ThyFriendlyFox/agentcast-prototype/agent-kit/STATUS.md

# STATUS.md — where the project actually stands

The single source of truth for project state. Claims require evidence: a
passing gate, a linked run, a tag. Updated in the same commit as the
behavior change. The weekly cycle (WEEKLY.md step 5) refreshes it.

| Area | State | Evidence |
|---|---|---|
| v0.5 stick with ESP32-P4, 80 x 30 mm, 8 layers | 🚧 | gates GREEN (ERC, DRC, SIM, EXPORT; `make verify`); not ordered: crystal value, DSI skew open (`hardware/v0.5/README.md`) |
| v0.5 fab files | ✅ | `hardware/v0.5/dongle/fab/` from `make fab` |
| v0.5 firmware | ❌ | not started |
| v0.4 CM5 stick with male plug | 🧊 | archived at `223e73b` |
| v0.3 stick design | 🧊 | archived at `f83c855`; superseded by v0.4 |
| v0.3 CM5 position | ✅ | matches Raspberry Pi's CM5 3D model (RP-007222-DD-2) |
| v0.3 fab files | ✅ | `hardware/v0.3/dongle/fab/` from `make fab` |
| v0.2 one-board dongle | 🧊 | archived at `6d5fa2a`; superseded by v0.3 |
| v0.1 main board and mic bar | 🧊 | archived at `2c0782a`; superseded by v0.2 |
| Firmware / OS image | ❌ | not started |

States: ✅ done (gated) · 🚧 in progress · ❌ not started · 🧊 frozen/won't do.

## Current week

- **Shipping:** between cycles
- **Last release:** none
- **Known red:** none.
