ThyFriendlyFox/agentcast-prototype/hardware/v0.5/dongle/docs/board-3d-top.png

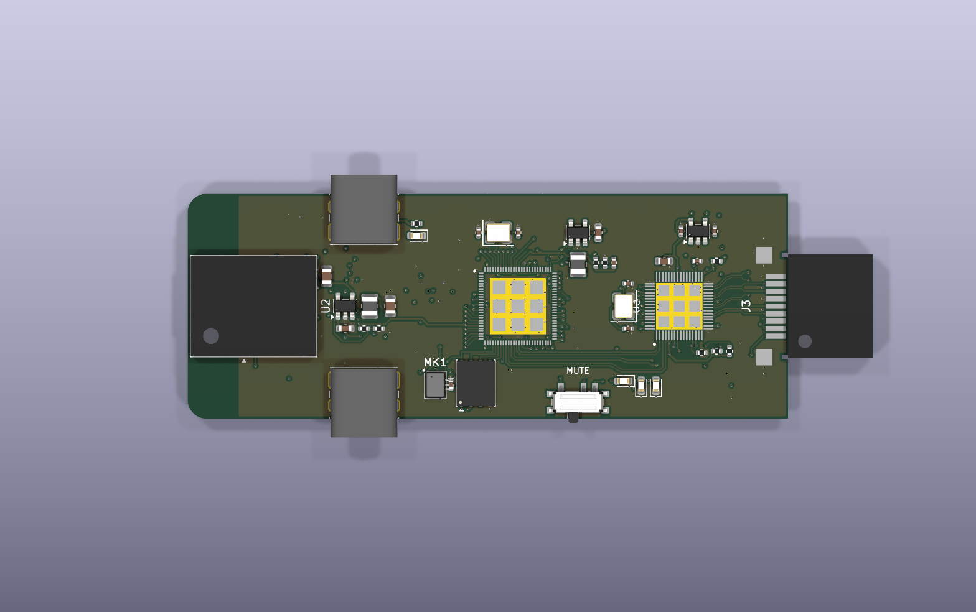
hardware/v0.5/dongle/docs/board-3d-top.png
