ThyFriendlyFox/agentcast-prototype/hardware/v0.5/dongle/docs/board-bottom.png

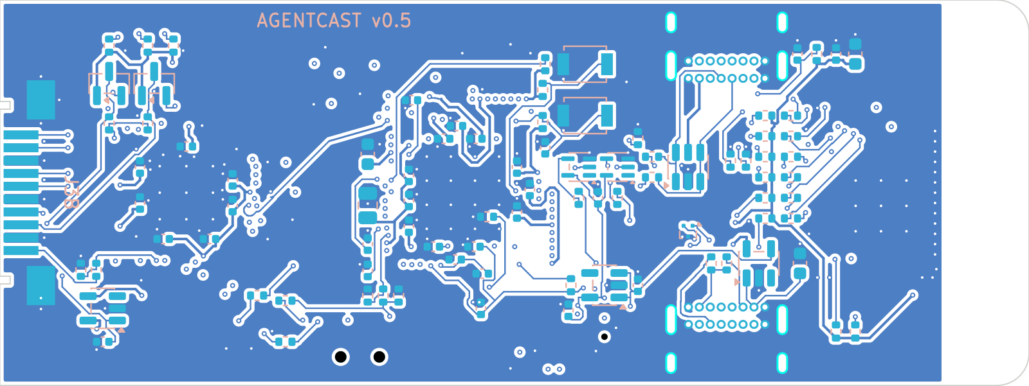
hardware/v0.5/dongle/docs/board-bottom.png
