ThyFriendlyFox/agentcast-prototype/hardware/v0.5/dongle/docs/board-top.png

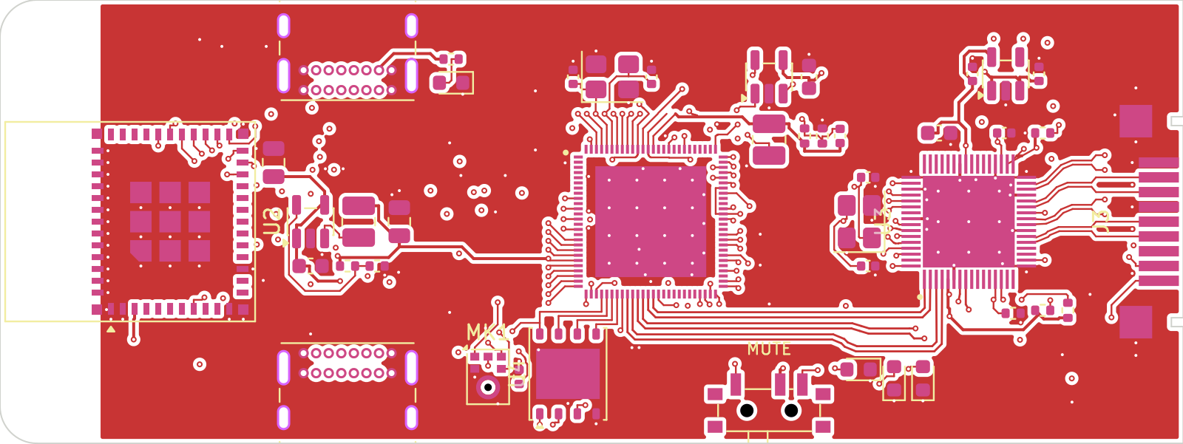
hardware/v0.5/dongle/docs/board-top.png
