ThyFriendlyFox/agentcast-prototype/hardware/v0.5/dongle/docs/layers/B-Courtyard.png

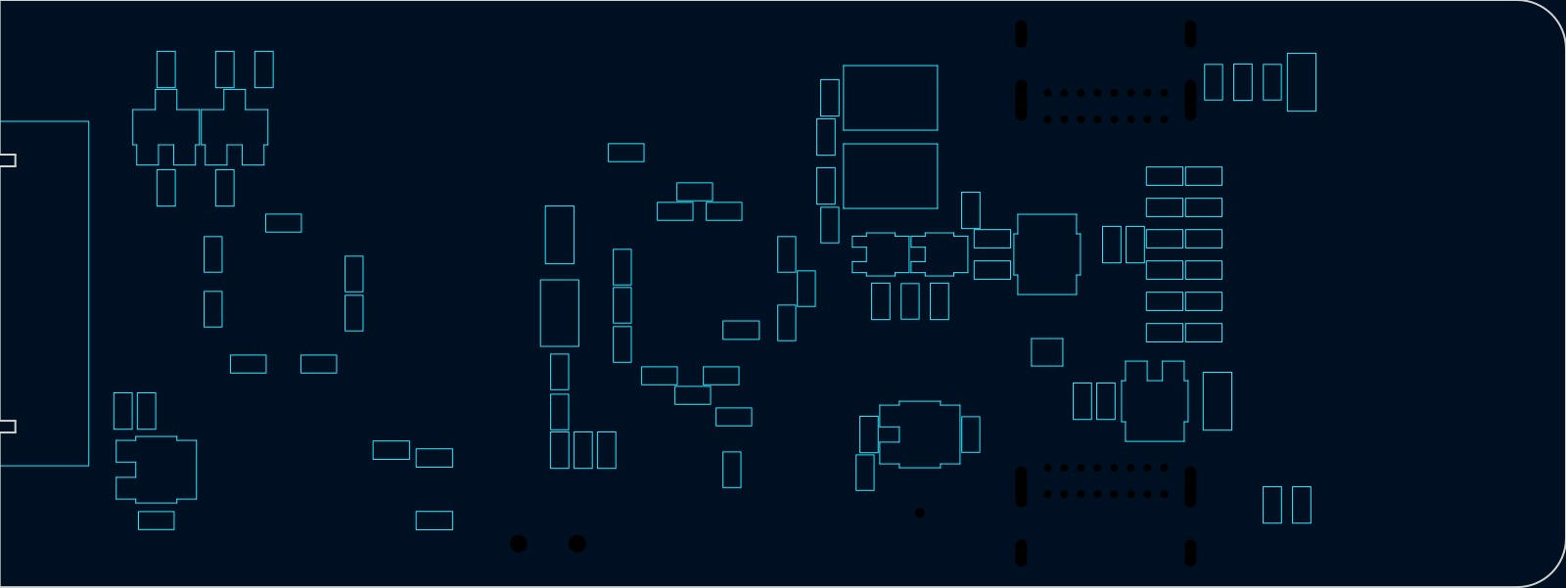
hardware/v0.5/dongle/docs/layers/B-Courtyard.png
