ThyFriendlyFox/agentcast-prototype/hardware/v0.5/dongle/docs/layers/B-Cu.png

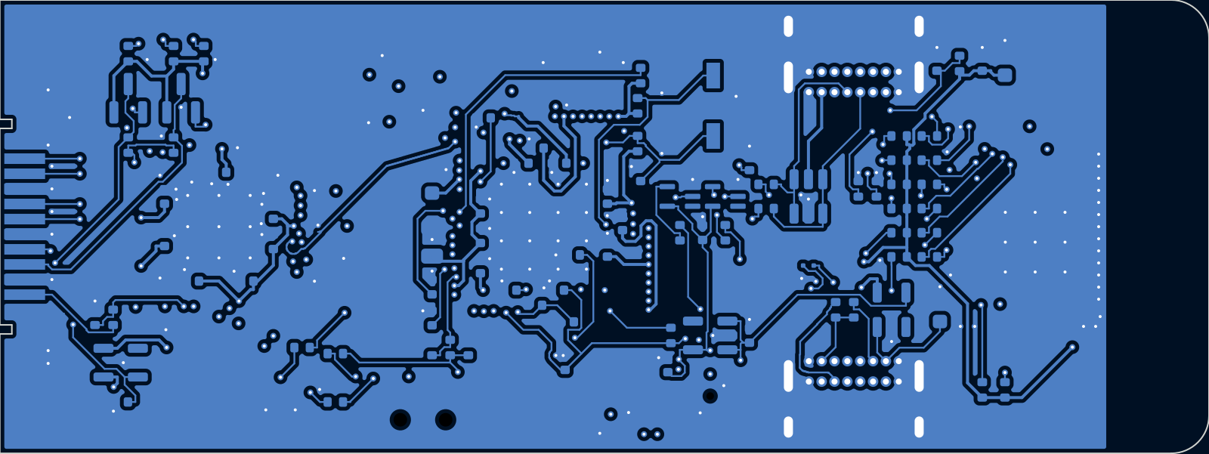
hardware/v0.5/dongle/docs/layers/B-Cu.png
