ThyFriendlyFox/agentcast-prototype/hardware/v0.5/dongle/docs/layers/B-Fab.png

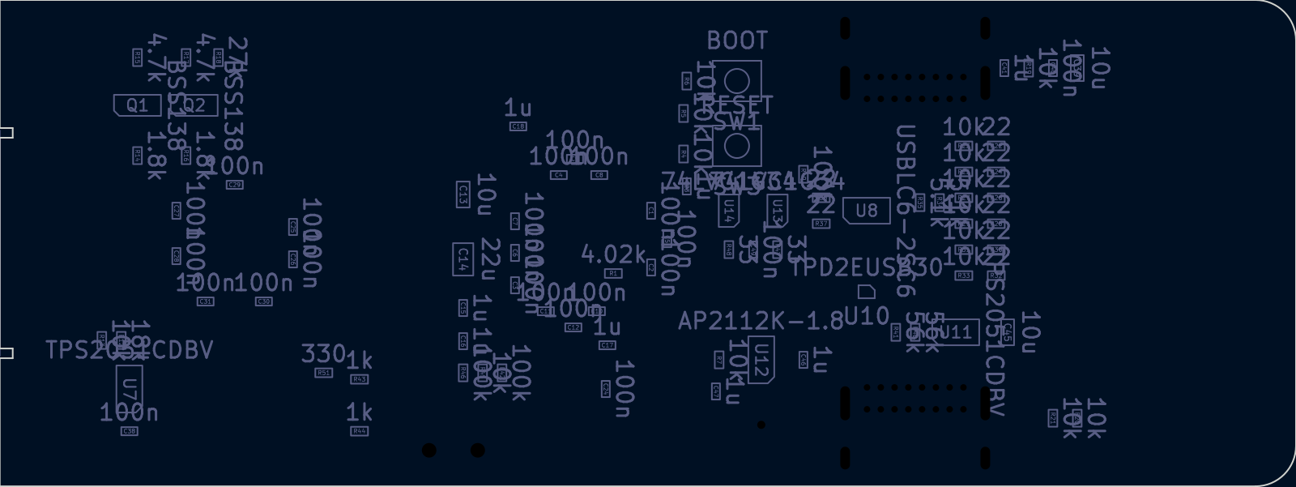
hardware/v0.5/dongle/docs/layers/B-Fab.png
