ThyFriendlyFox/agentcast-prototype/hardware/v0.5/dongle/docs/layers/B-Mask.png

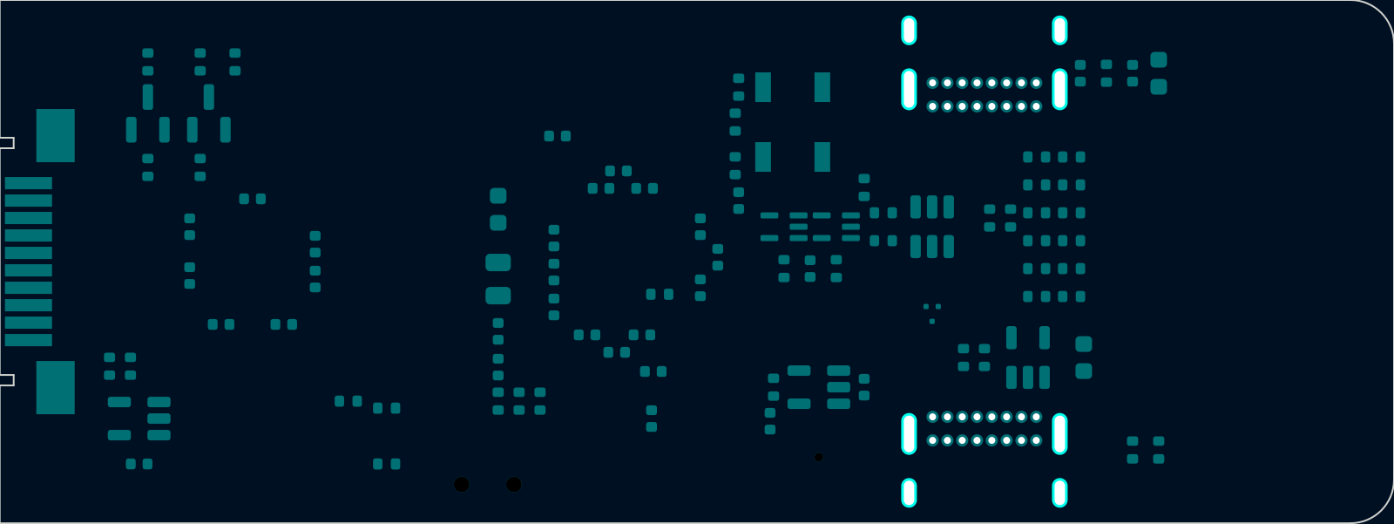
hardware/v0.5/dongle/docs/layers/B-Mask.png
