ThyFriendlyFox/agentcast-prototype/hardware/v0.5/dongle/docs/layers/B-Paste.png

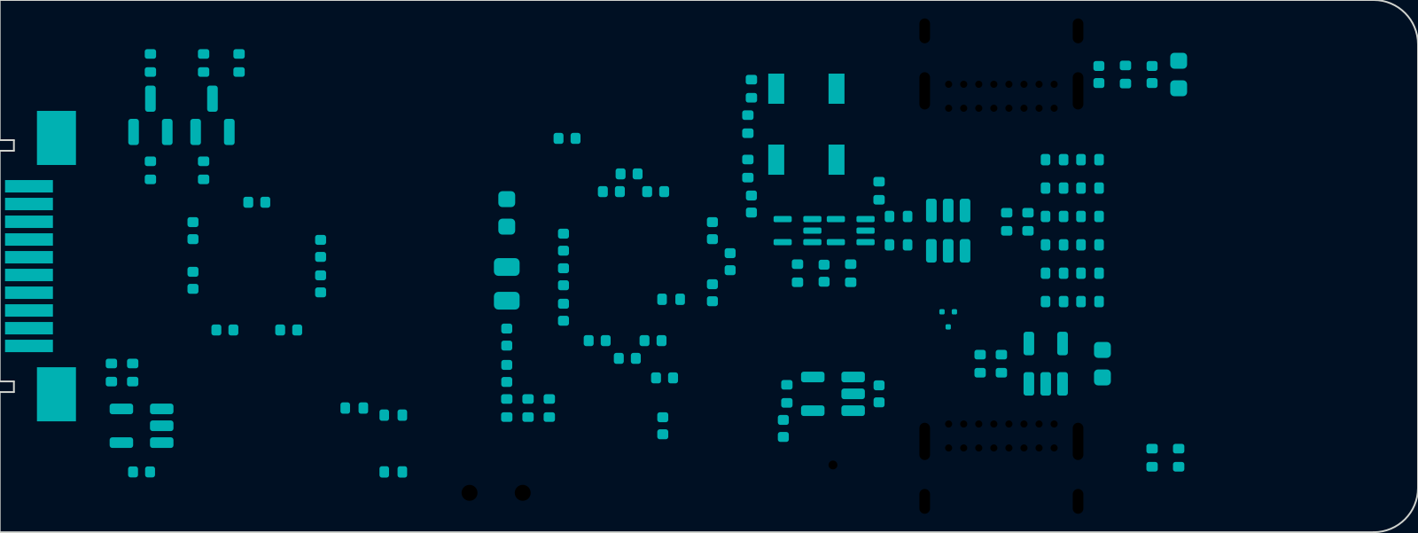
hardware/v0.5/dongle/docs/layers/B-Paste.png
