ThyFriendlyFox/agentcast-prototype/hardware/v0.5/dongle/docs/layers/B-Silkscreen.png

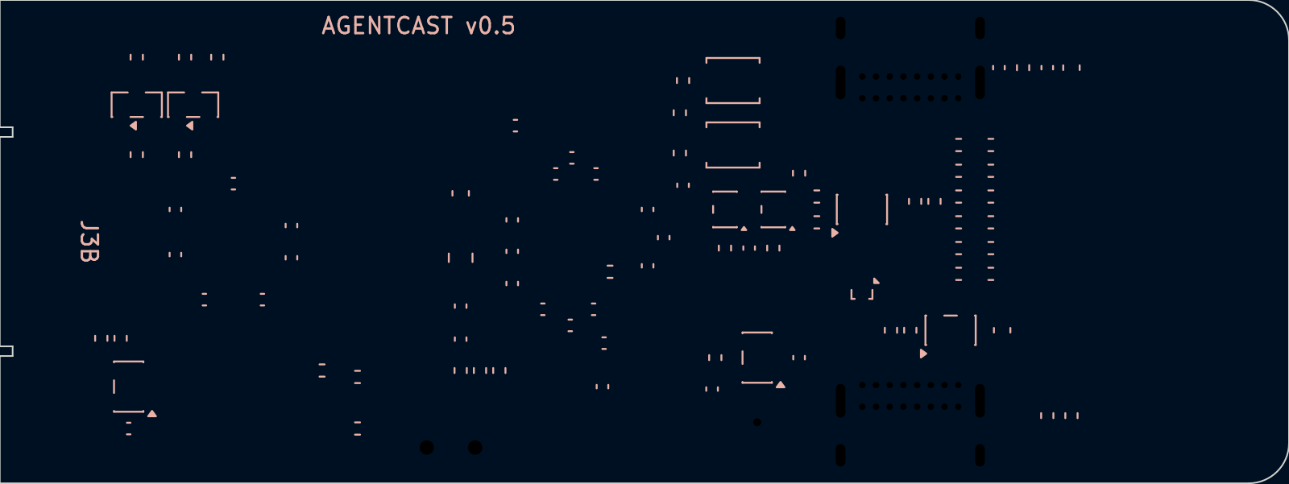
hardware/v0.5/dongle/docs/layers/B-Silkscreen.png
