ThyFriendlyFox/agentcast-prototype/hardware/v0.5/dongle/docs/layers/Edge-Cuts.png

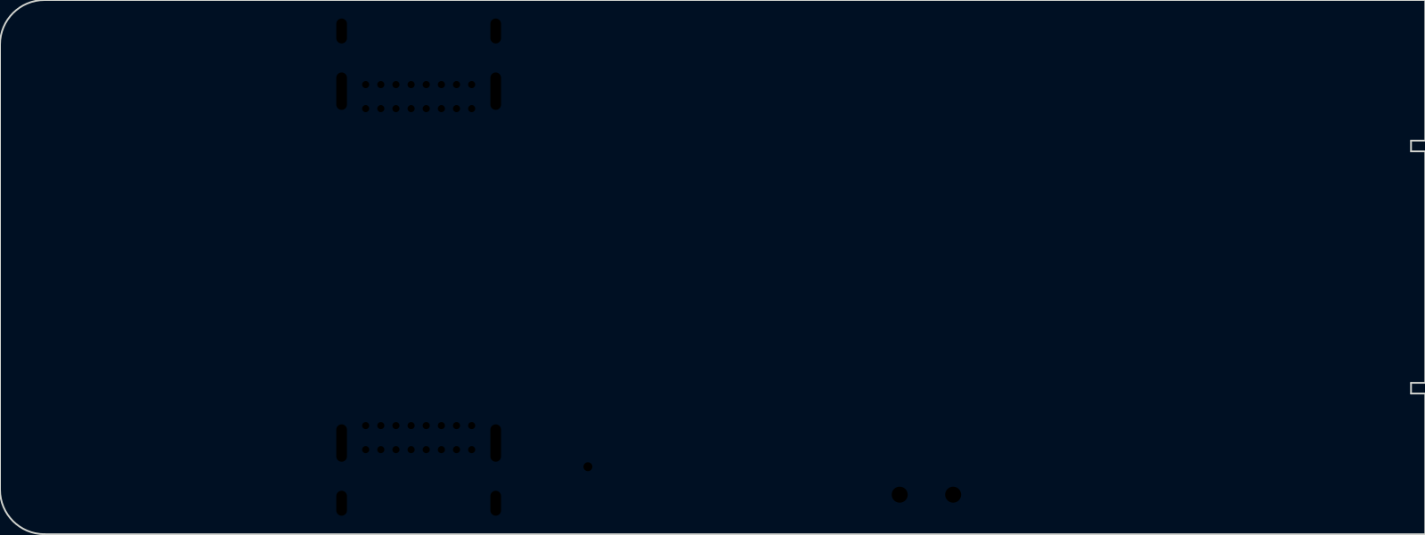
hardware/v0.5/dongle/docs/layers/Edge-Cuts.png
