ThyFriendlyFox/agentcast-prototype/hardware/v0.5/dongle/docs/layers/F-Courtyard.png

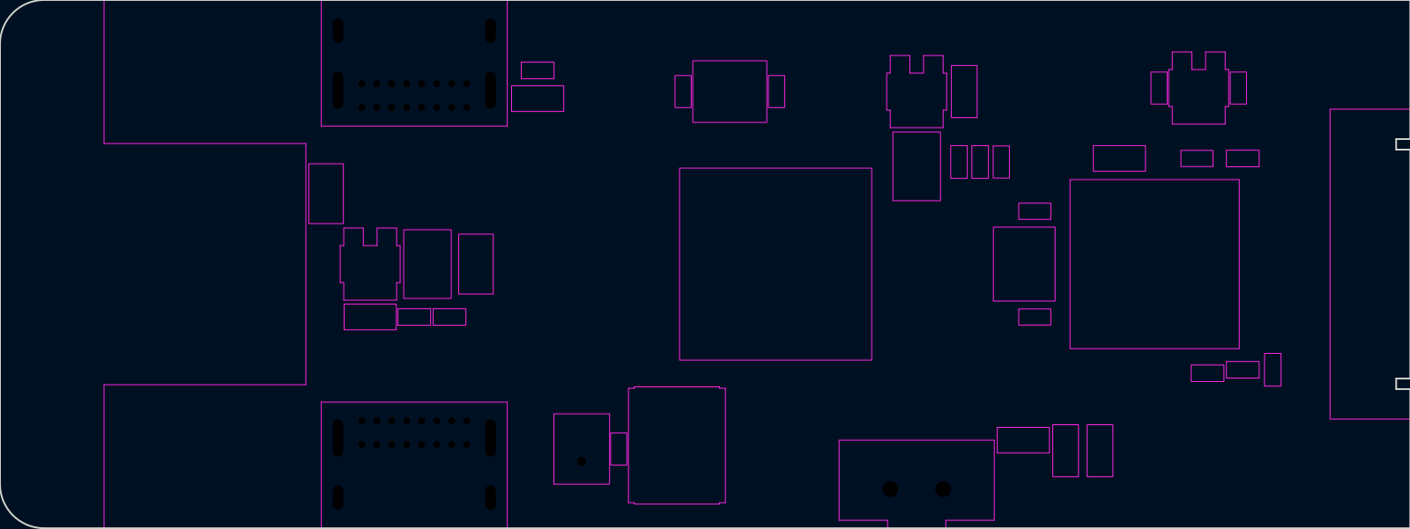
hardware/v0.5/dongle/docs/layers/F-Courtyard.png
