ThyFriendlyFox/agentcast-prototype/hardware/v0.5/dongle/docs/layers/F-Cu.png

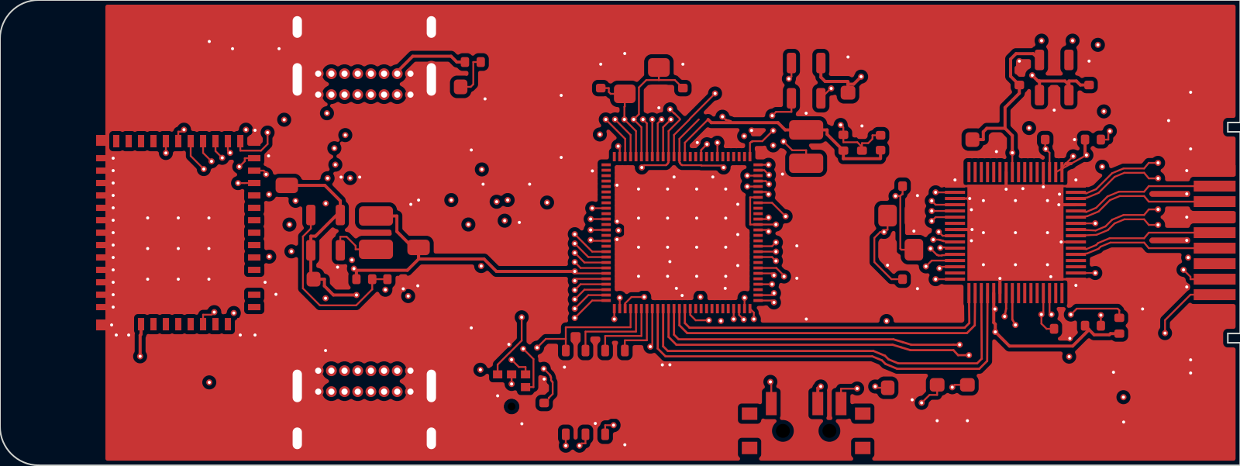
hardware/v0.5/dongle/docs/layers/F-Cu.png
