ThyFriendlyFox/agentcast-prototype/hardware/v0.5/dongle/docs/layers/F-Fab.png

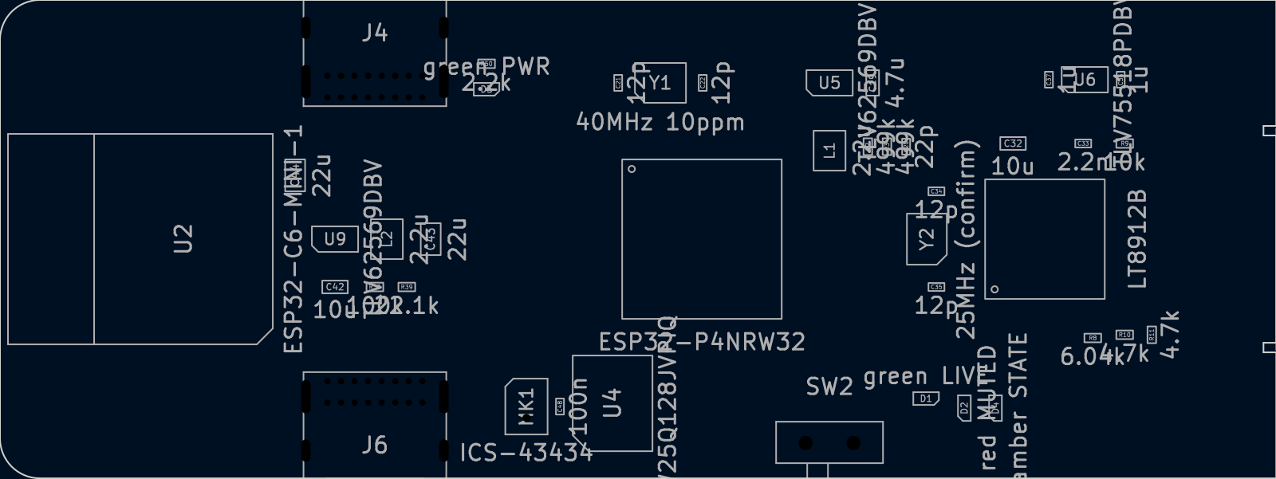
hardware/v0.5/dongle/docs/layers/F-Fab.png
