ThyFriendlyFox/agentcast-prototype/hardware/v0.5/dongle/docs/layers/F-Mask.png

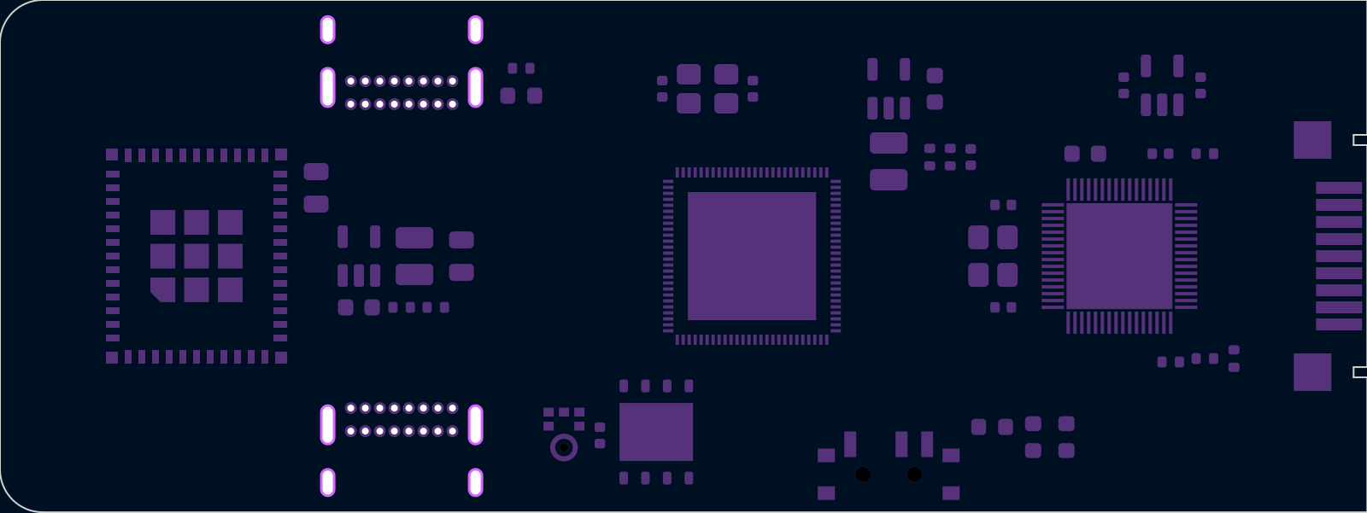
hardware/v0.5/dongle/docs/layers/F-Mask.png
