ThyFriendlyFox/agentcast-prototype/hardware/v0.5/dongle/docs/layers/F-Paste.png

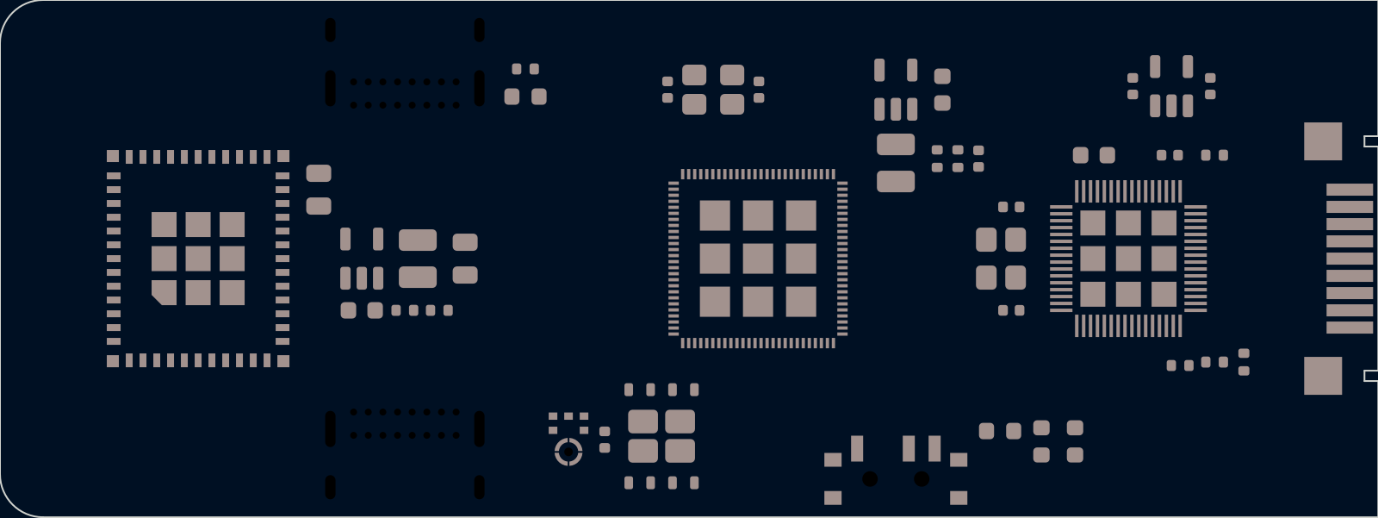
hardware/v0.5/dongle/docs/layers/F-Paste.png
