ThyFriendlyFox/agentcast-prototype/hardware/v0.5/dongle/docs/layers/F-Silkscreen.png

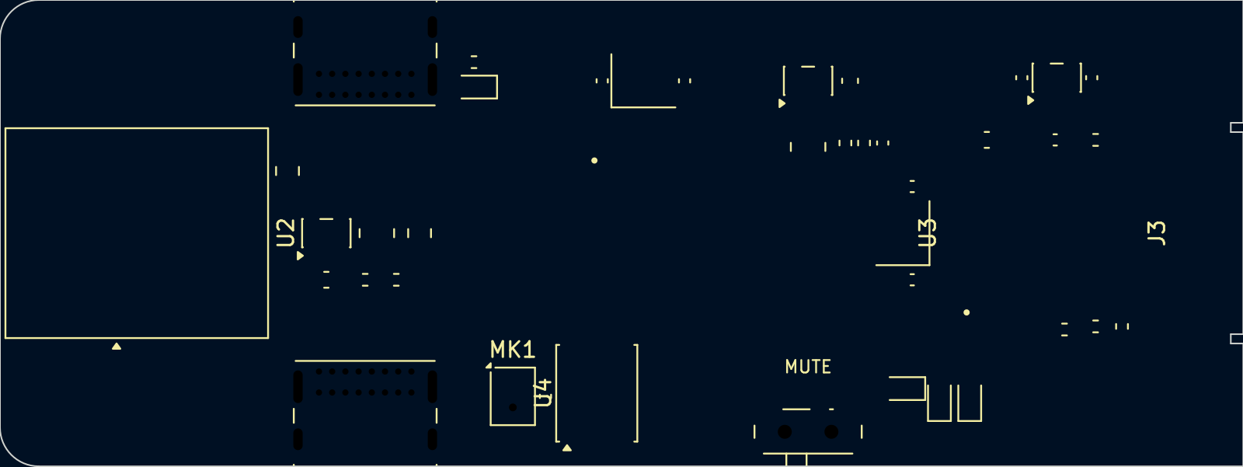
hardware/v0.5/dongle/docs/layers/F-Silkscreen.png
