ThyFriendlyFox/agentcast-prototype/hardware/v0.5/dongle/docs/layers/In1-Cu.png

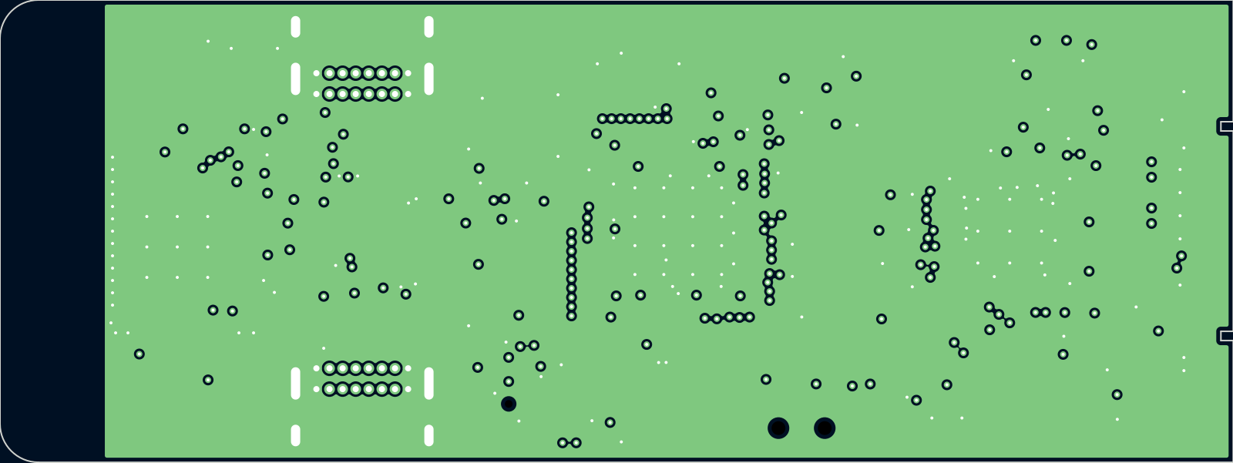
hardware/v0.5/dongle/docs/layers/In1-Cu.png
