ThyFriendlyFox/agentcast-prototype/hardware/v0.5/dongle/docs/layers/In4-Cu.png

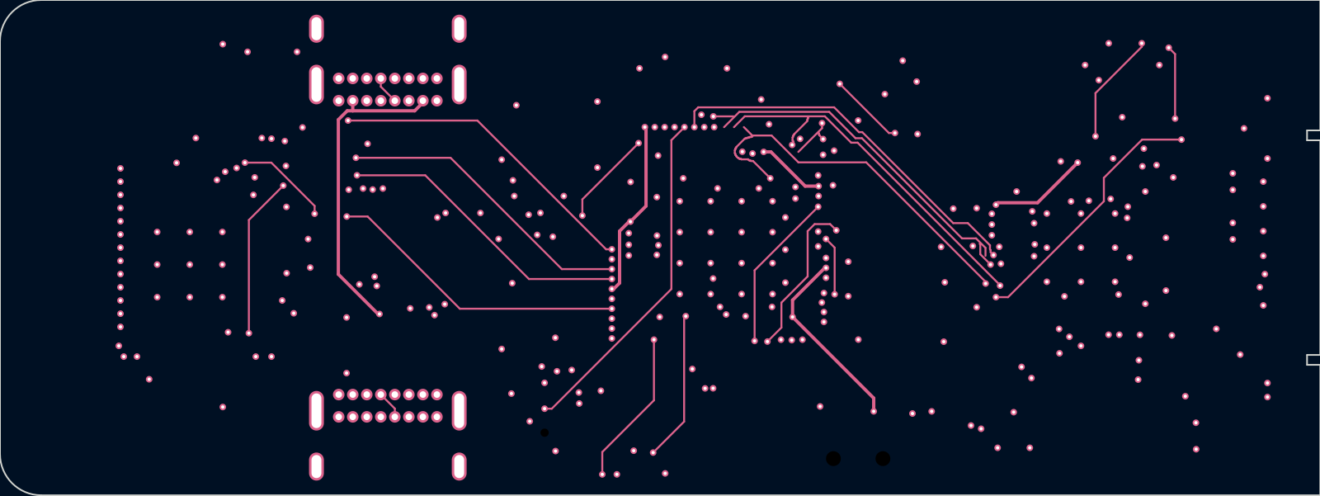
hardware/v0.5/dongle/docs/layers/In4-Cu.png
