ThyFriendlyFox/agentcast-prototype/hardware/v0.5/dongle/docs/layers/In5-Cu.png

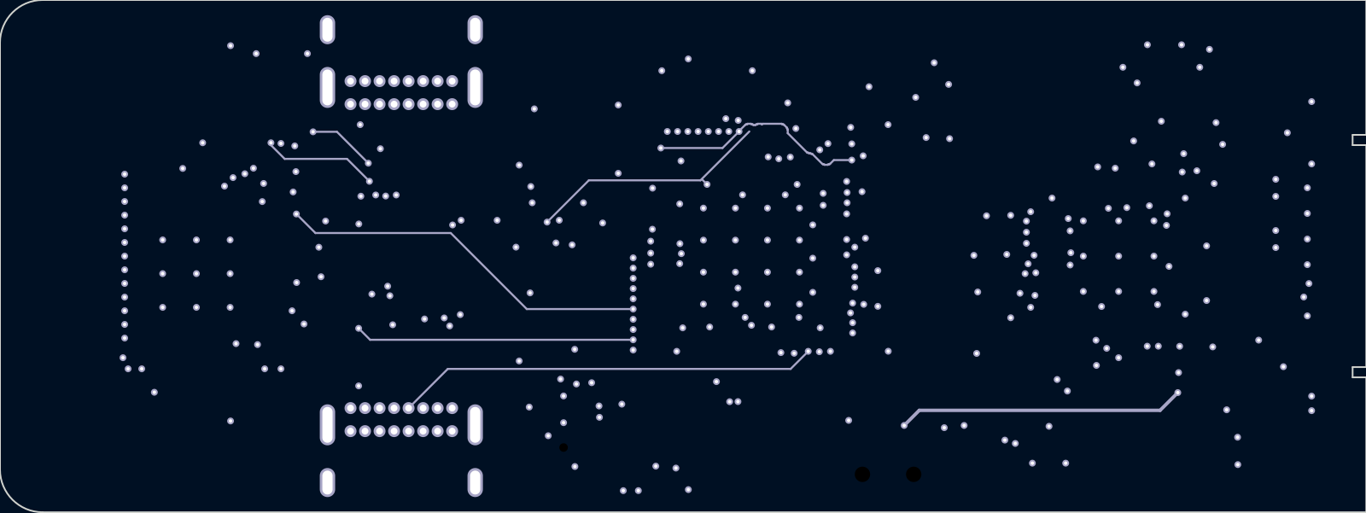
hardware/v0.5/dongle/docs/layers/In5-Cu.png
