ThyFriendlyFox/agentcast-prototype/hardware/v0.5/dongle/docs/schematic.png

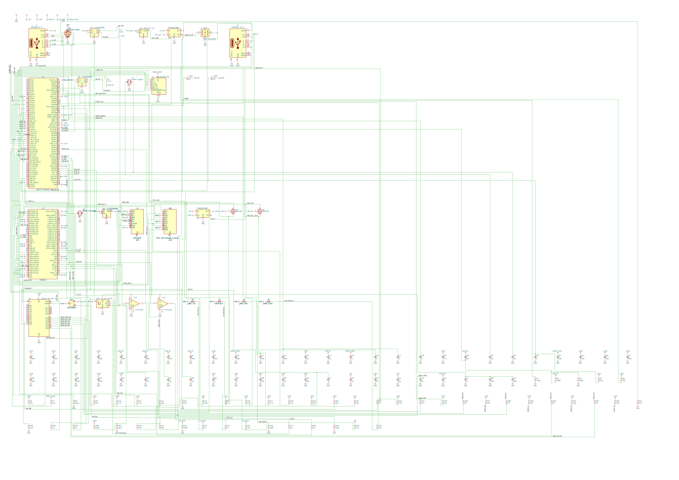
hardware/v0.5/dongle/docs/schematic.png
