ThyFriendlyFox/agentcast-prototype/hardware/v0.5/dongle/fab/bom.csv

Refs | Value | Footprint | Qty | DNP
C1 | 100n | Capacitor_SMD:C_0402_1005Metric | 1
C2 | 100n | Capacitor_SMD:C_0402_1005Metric | 1
C3 | 100n | Capacitor_SMD:C_0402_1005Metric | 1
C4 | 100n | Capacitor_SMD:C_0402_1005Metric | 1
C5 | 100n | Capacitor_SMD:C_0402_1005Metric | 1
C6 | 100n | Capacitor_SMD:C_0402_1005Metric | 1
C7 | 100n | Capacitor_SMD:C_0402_1005Metric | 1
C8 | 100n | Capacitor_SMD:C_0402_1005Metric | 1
C9 | 100n | Capacitor_SMD:C_0402_1005Metric | 1
C10 | 100n | Capacitor_SMD:C_0402_1005Metric | 1
C11 | 100n | Capacitor_SMD:C_0402_1005Metric | 1
C12 | 100n | Capacitor_SMD:C_0402_1005Metric | 1
C13 | 10u | Capacitor_SMD:C_0603_1608Metric | 1
C14 | 22u | Capacitor_SMD:C_0805_2012Metric | 1
C15 | 1u | Capacitor_SMD:C_0402_1005Metric | 1
C16 | 1u | Capacitor_SMD:C_0402_1005Metric | 1
C17 | 1u | Capacitor_SMD:C_0402_1005Metric | 1
C18 | 1u | Capacitor_SMD:C_0402_1005Metric | 1
C19 | 4.7u | Capacitor_SMD:C_0603_1608Metric | 1
C20 | 22p | Capacitor_SMD:C_0402_1005Metric | 1
C21 | 12p | Capacitor_SMD:C_0402_1005Metric | 1
C22 | 12p | Capacitor_SMD:C_0402_1005Metric | 1
C23 | 1u | Capacitor_SMD:C_0402_1005Metric | 1
C24 | 100n | Capacitor_SMD:C_0402_1005Metric | 1
C25 | 100n | Capacitor_SMD:C_0402_1005Metric | 1
C26 | 100n | Capacitor_SMD:C_0402_1005Metric | 1
C27 | 100n | Capacitor_SMD:C_0402_1005Metric | 1
C28 | 100n | Capacitor_SMD:C_0402_1005Metric | 1
C29 | 100n | Capacitor_SMD:C_0402_1005Metric | 1
C30 | 100n | Capacitor_SMD:C_0402_1005Metric | 1
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
U2 | ESP32-C6-MINI-1 | RF_Module:ESP32-C6-MINI-1 | 1
U3 | LT8912B | Agentcast:QFN-64-1EP_7.5x7.5mm_P0.4mm_EP6.2x6.2mm | 1
U4 | W25Q128JVPIQ | Package_SON:WSON-8-1EP_6x5mm_P1.27mm_EP3.4x4.3mm | 1
U5 | TLV62569DBV | Package_TO_SOT_SMD:SOT-23-5 | 1
U6 | TLV75518PDBV | Package_TO_SOT_SMD:SOT-23-5 | 1
U7 | TPS2051CDBV | Package_TO_SOT_SMD:SOT-23-5 | 1
U8 | USBLC6-2SC6 | Package_TO_SOT_SMD:SOT-23-6 | 1
U9 | TLV62569DBV | Package_TO_SOT_SMD:SOT-23-5 | 1
U10 | TPD2EUSB30 | Package_TO_SOT_SMD:Texas_DRT-3 | 1
U11 | TPS2051CDBV | Package_TO_SOT_SMD:SOT-23-5 | 1
U12 | AP2112K-1.8 | Package_TO_SOT_SMD:SOT-23-5 | 1
U13 | 74LVC1G34 | Package_TO_SOT_SMD:SOT-353_SC-70-5 | 1
U14 | 74LVC1G34 | Package_TO_SOT_SMD:SOT-353_SC-70-5 | 1
Y1 | 40MHz 10ppm | Crystal:Crystal_SMD_3225-4Pin_3.2x2.5mm | 1
Y2 | 25MHz (confirm) | Crystal:Crystal_SMD_3225-4Pin_3.2x2.5mm | 1
