ThyFriendlyFox/agentcast-prototype/agent-kit/CHANGELOG.md

# Changelog

All notable changes to Agentcast are documented here.
Format: [Keep a Changelog](https://keepachangelog.com/) · Versioning: [SemVer](https://semver.org/).

## [Unreleased]
### Added
- Hardware v0.5: an 80 x 30 mm, 8-layer stick with an ESP32-P4, LT8912B HDMI bridge, ESP32-C6 Wi-Fi and the XUNPU HDMI-003 plug per its drawing.
- Hardware v0.4: a male HDMI Type-A plug on the stick's end (plugs straight into the TV); plug footprint awaits the part's drawing.
- Hardware v0.3: a 67 x 46 mm stick, HDMI out of the end, USB-C power and USB-C external mic on the sides; CM5 position checked against Raspberry Pi's 3D model; every part has a 3D body.
- Hardware v0.2: one board (57 x 50.4 mm) with an on-board mic, a USB-C port for an external mic, and a hardware mute that covers both. Fab files in `hardware/v0.2/dongle/fab/`.
- Hardware v0.1: main board (CM5 carrier, HDMI-A, USB-C) and mic bar (4 I2S mics, hardware mute).
- Agent kit, Makefile (`make verify`).
### Changed
### Deprecated
### Removed
### Fixed
### Security
