ThyFriendlyFox/agentcast-prototype/hardware/v0.5/dongle/fab/schematic.pdf

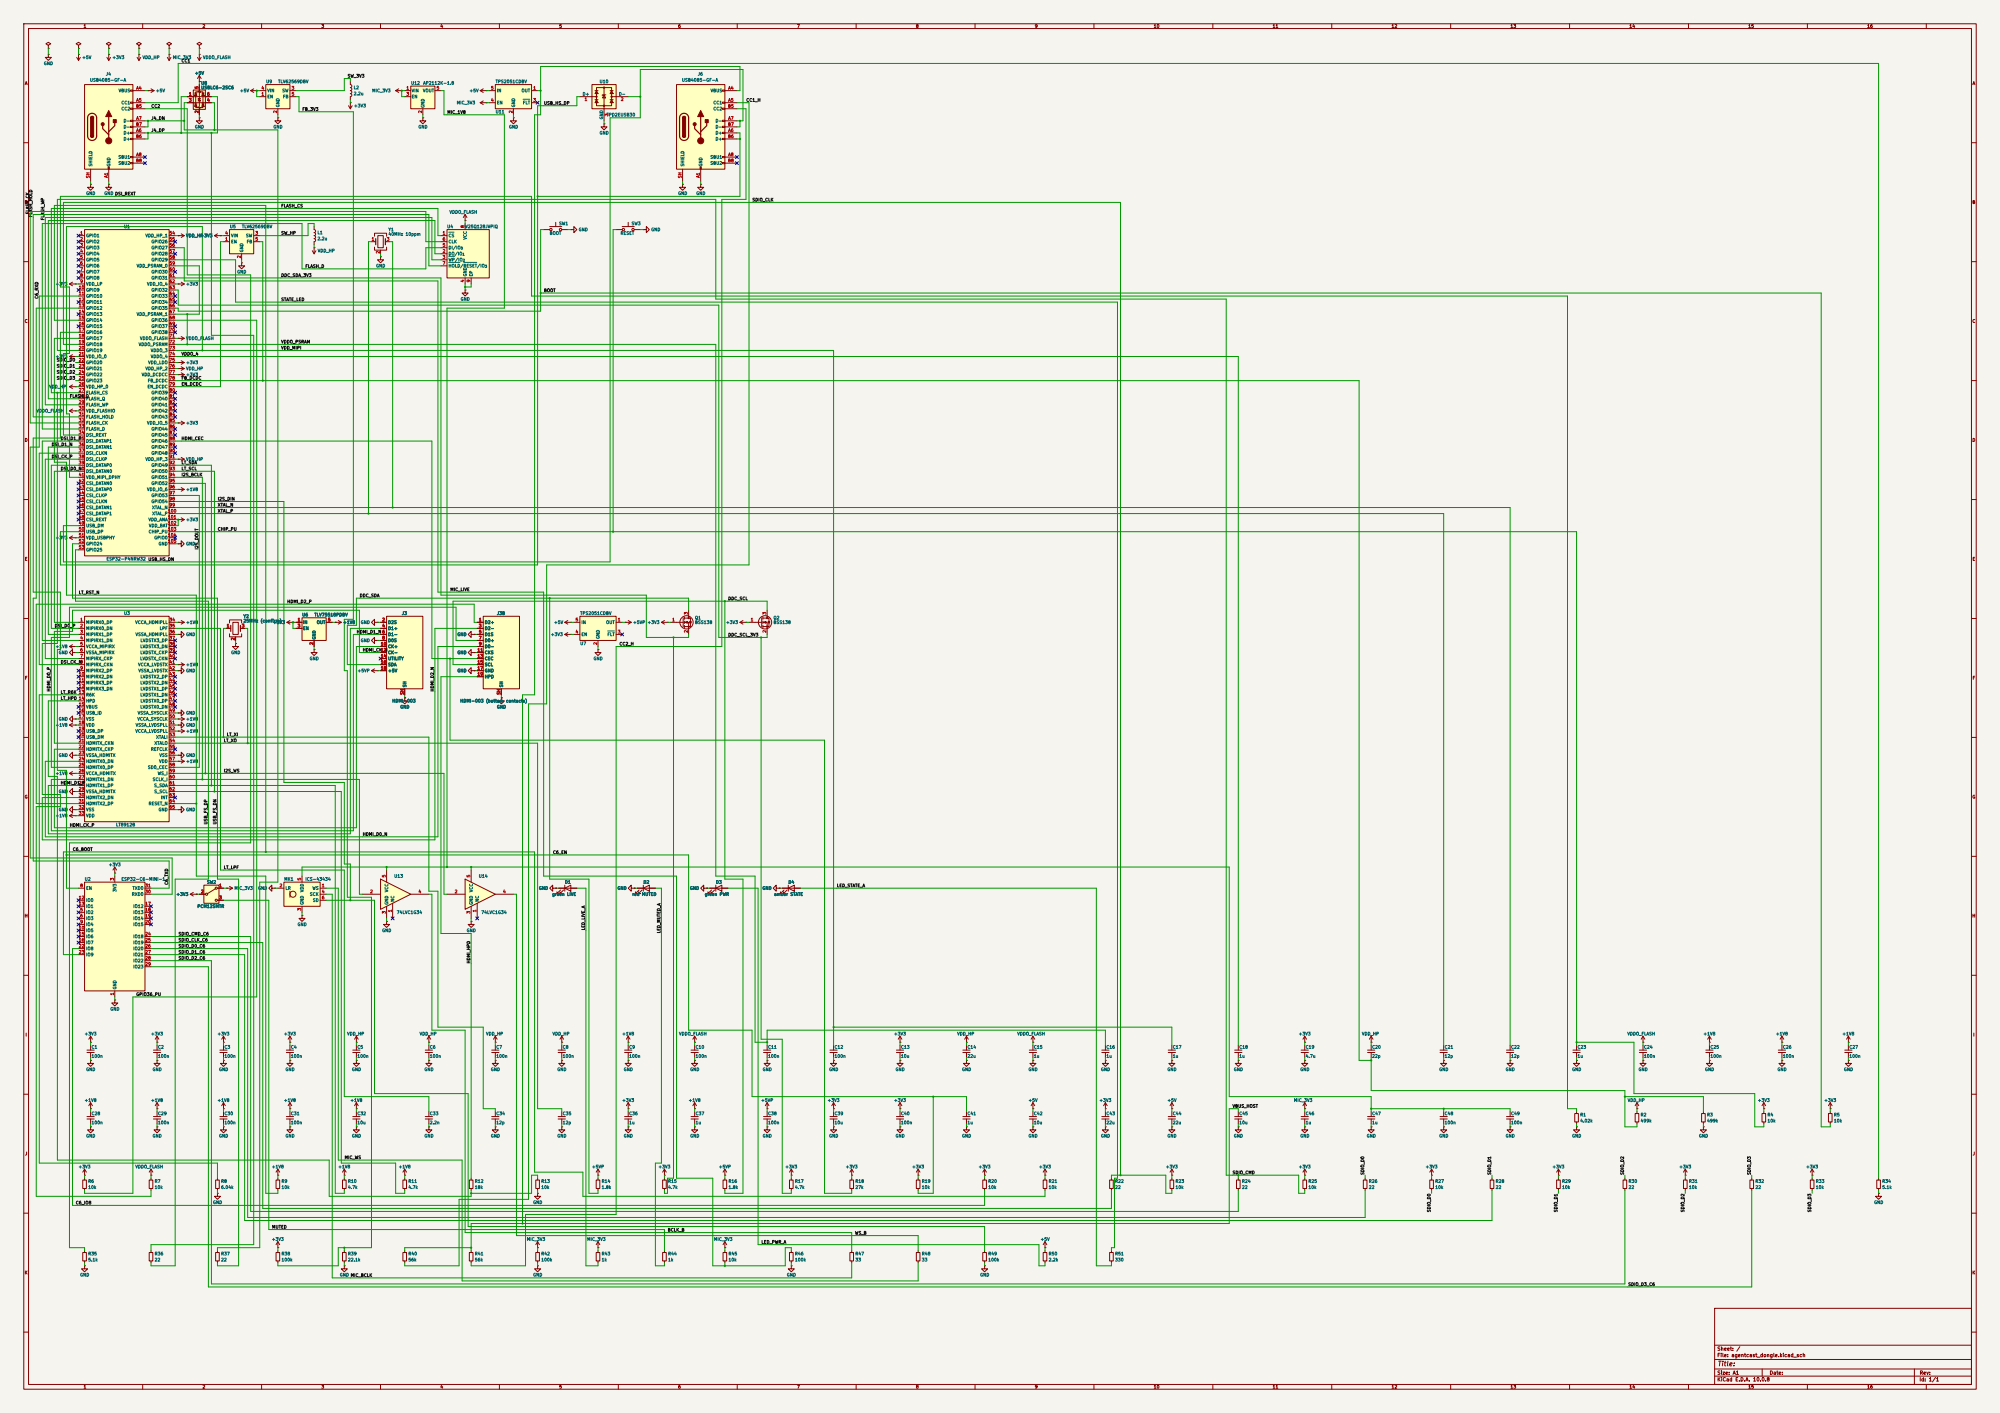
[picture p47: page 1]

4 DI/IO0 5 CLK 6 HOLD/RESET/IO3 7 VCC

VDDO_FLASH | | DDC_SDA_3V3 DSI_D1_P

VDDO_PSRAM
VDD_MIPI

J3B HDMI-003 (bottom contacts) GND

22 GND

LED_PWR_A

Size: A1 | Rev:
KiCad E.D.A. 10.0.8 | Id: 1/1
