ThyFriendlyFox/agentcast-prototype/hardware/v0.4/dongle/fab/schematic.pdf

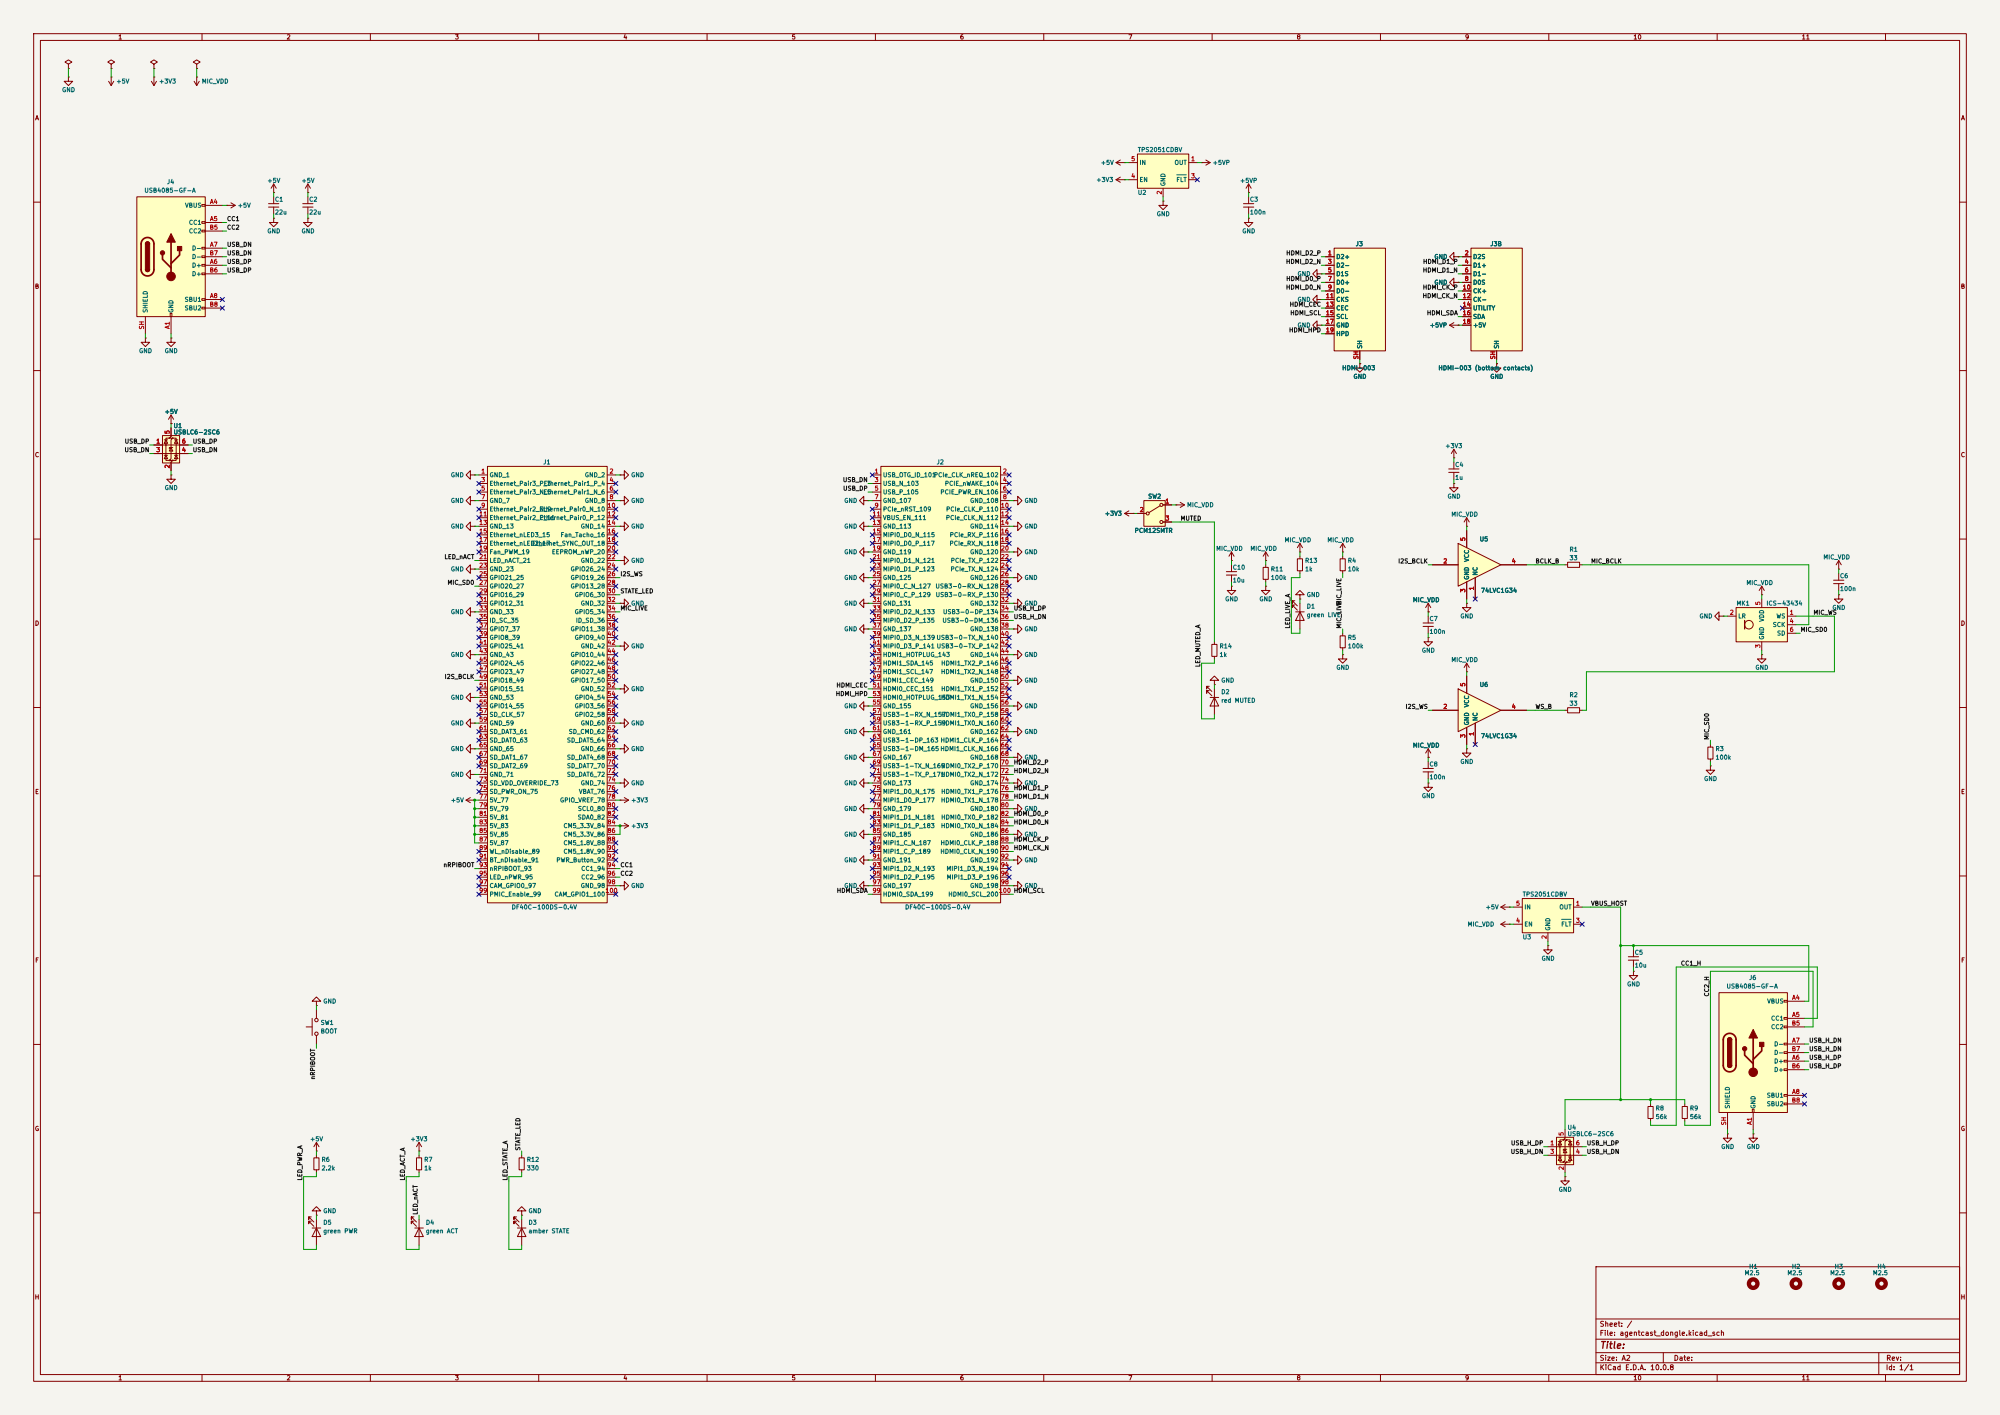
[picture p48: page 1]

Size: A2 | Rev:
KiCad E.D.A. 10.0.8 | Id: 1/1
