ThyFriendlyFox/agentcast-prototype/hardware/v0.2/dongle/fab/schematic.pdf

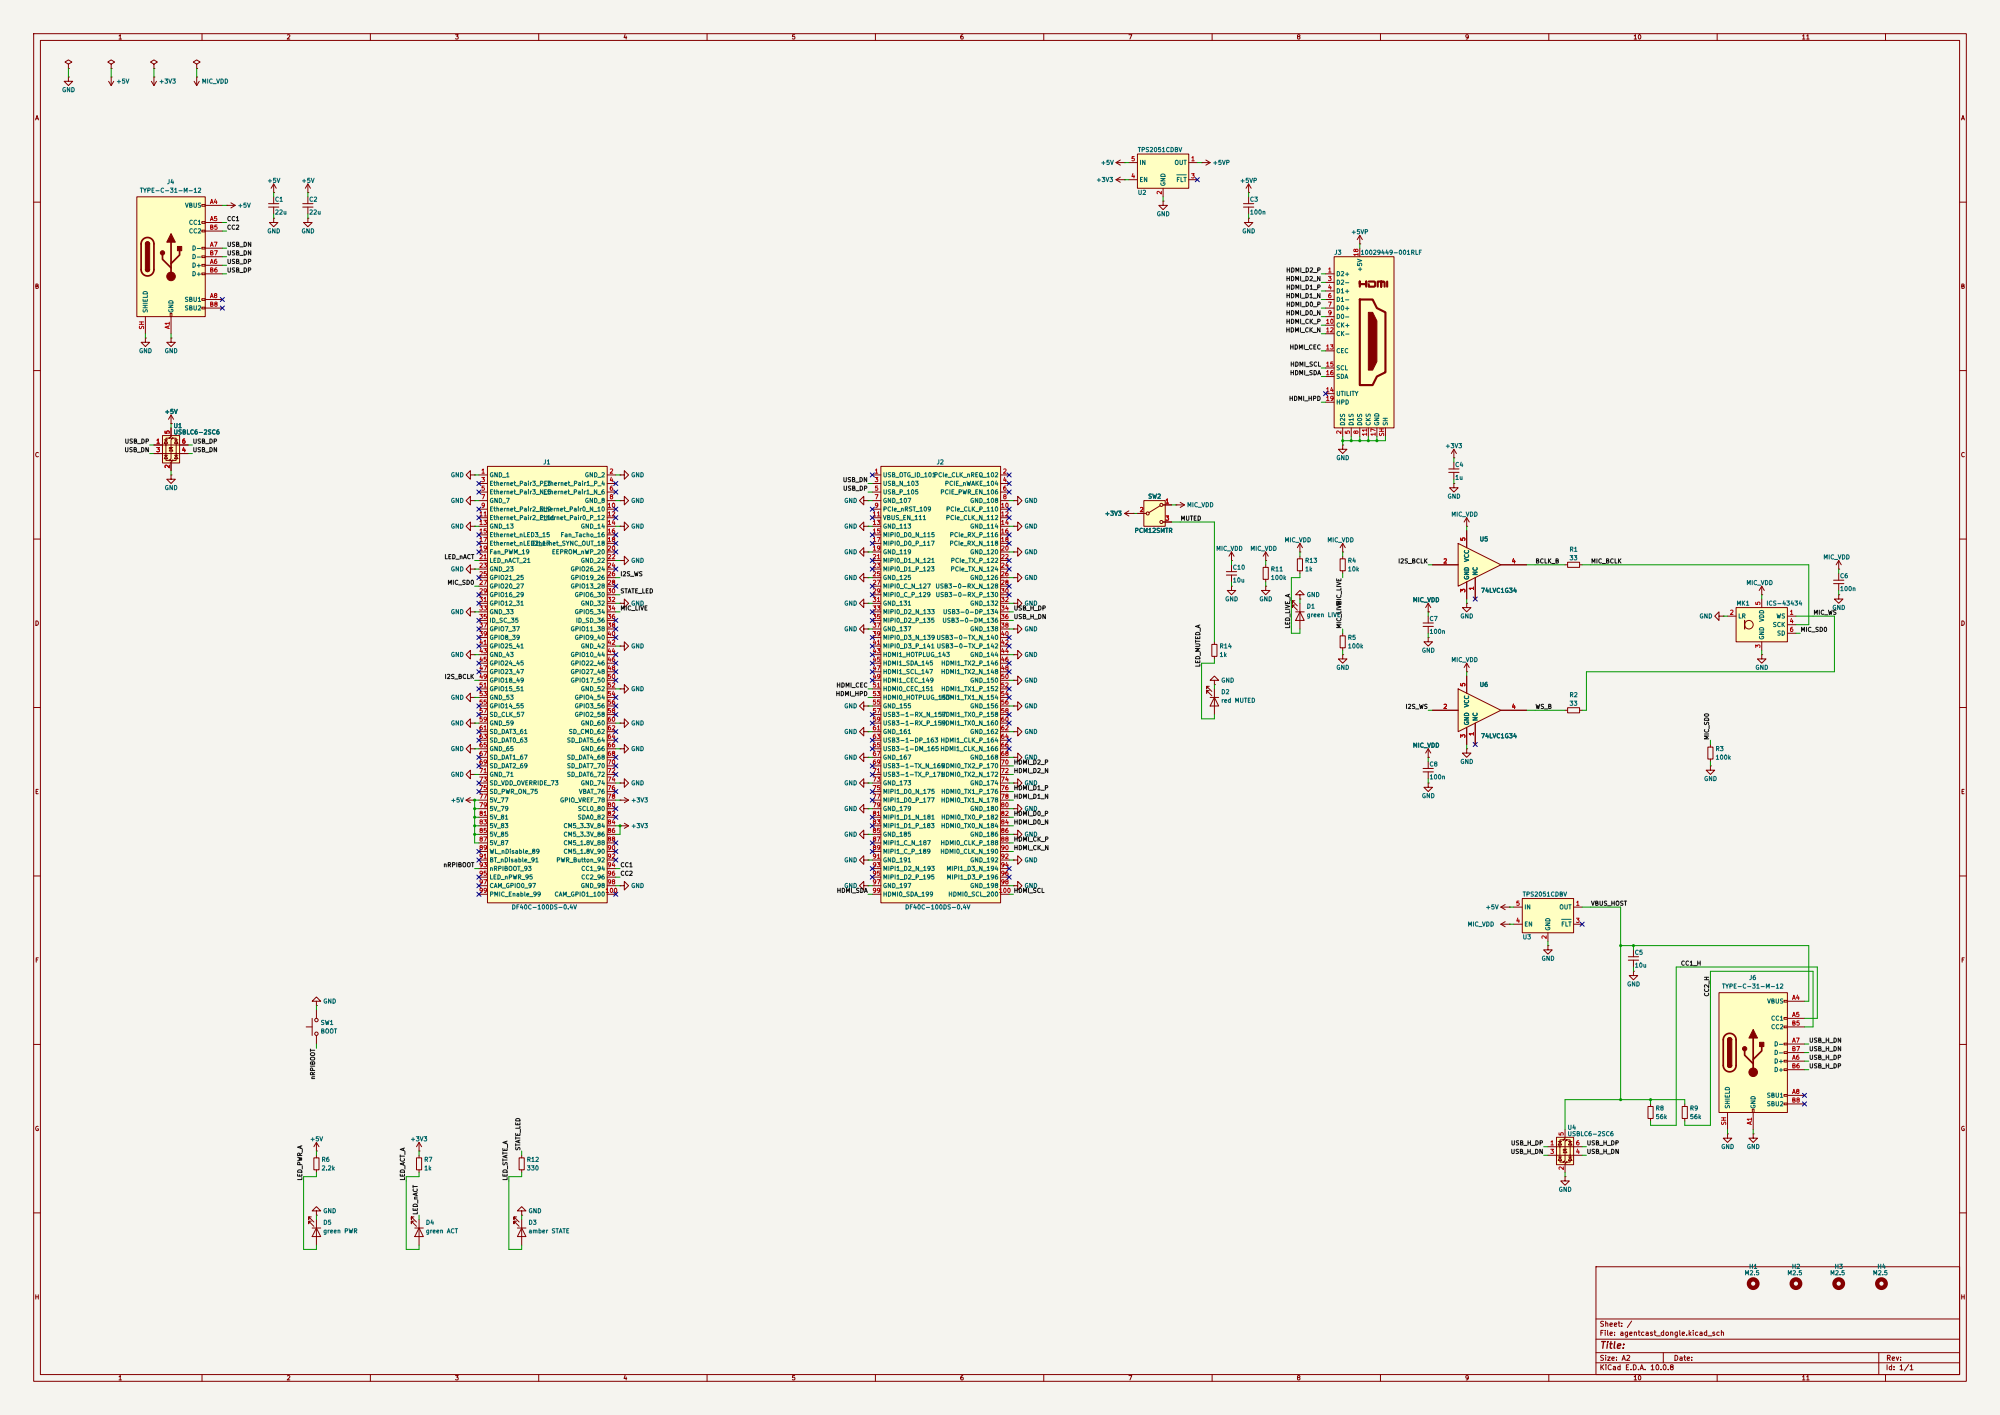
[picture p50: page 1]

Size: A2 | Rev:
KiCad E.D.A. 10.0.8 | Id: 1/1
