ThyFriendlyFox/agentcast-prototype/hardware/v0.5/dongle/agentcast_dongle.kicad_pcb

## KiCad design hardware/v0.5/dongle/agentcast_dongle.kicad_pcb (2026-11-08)

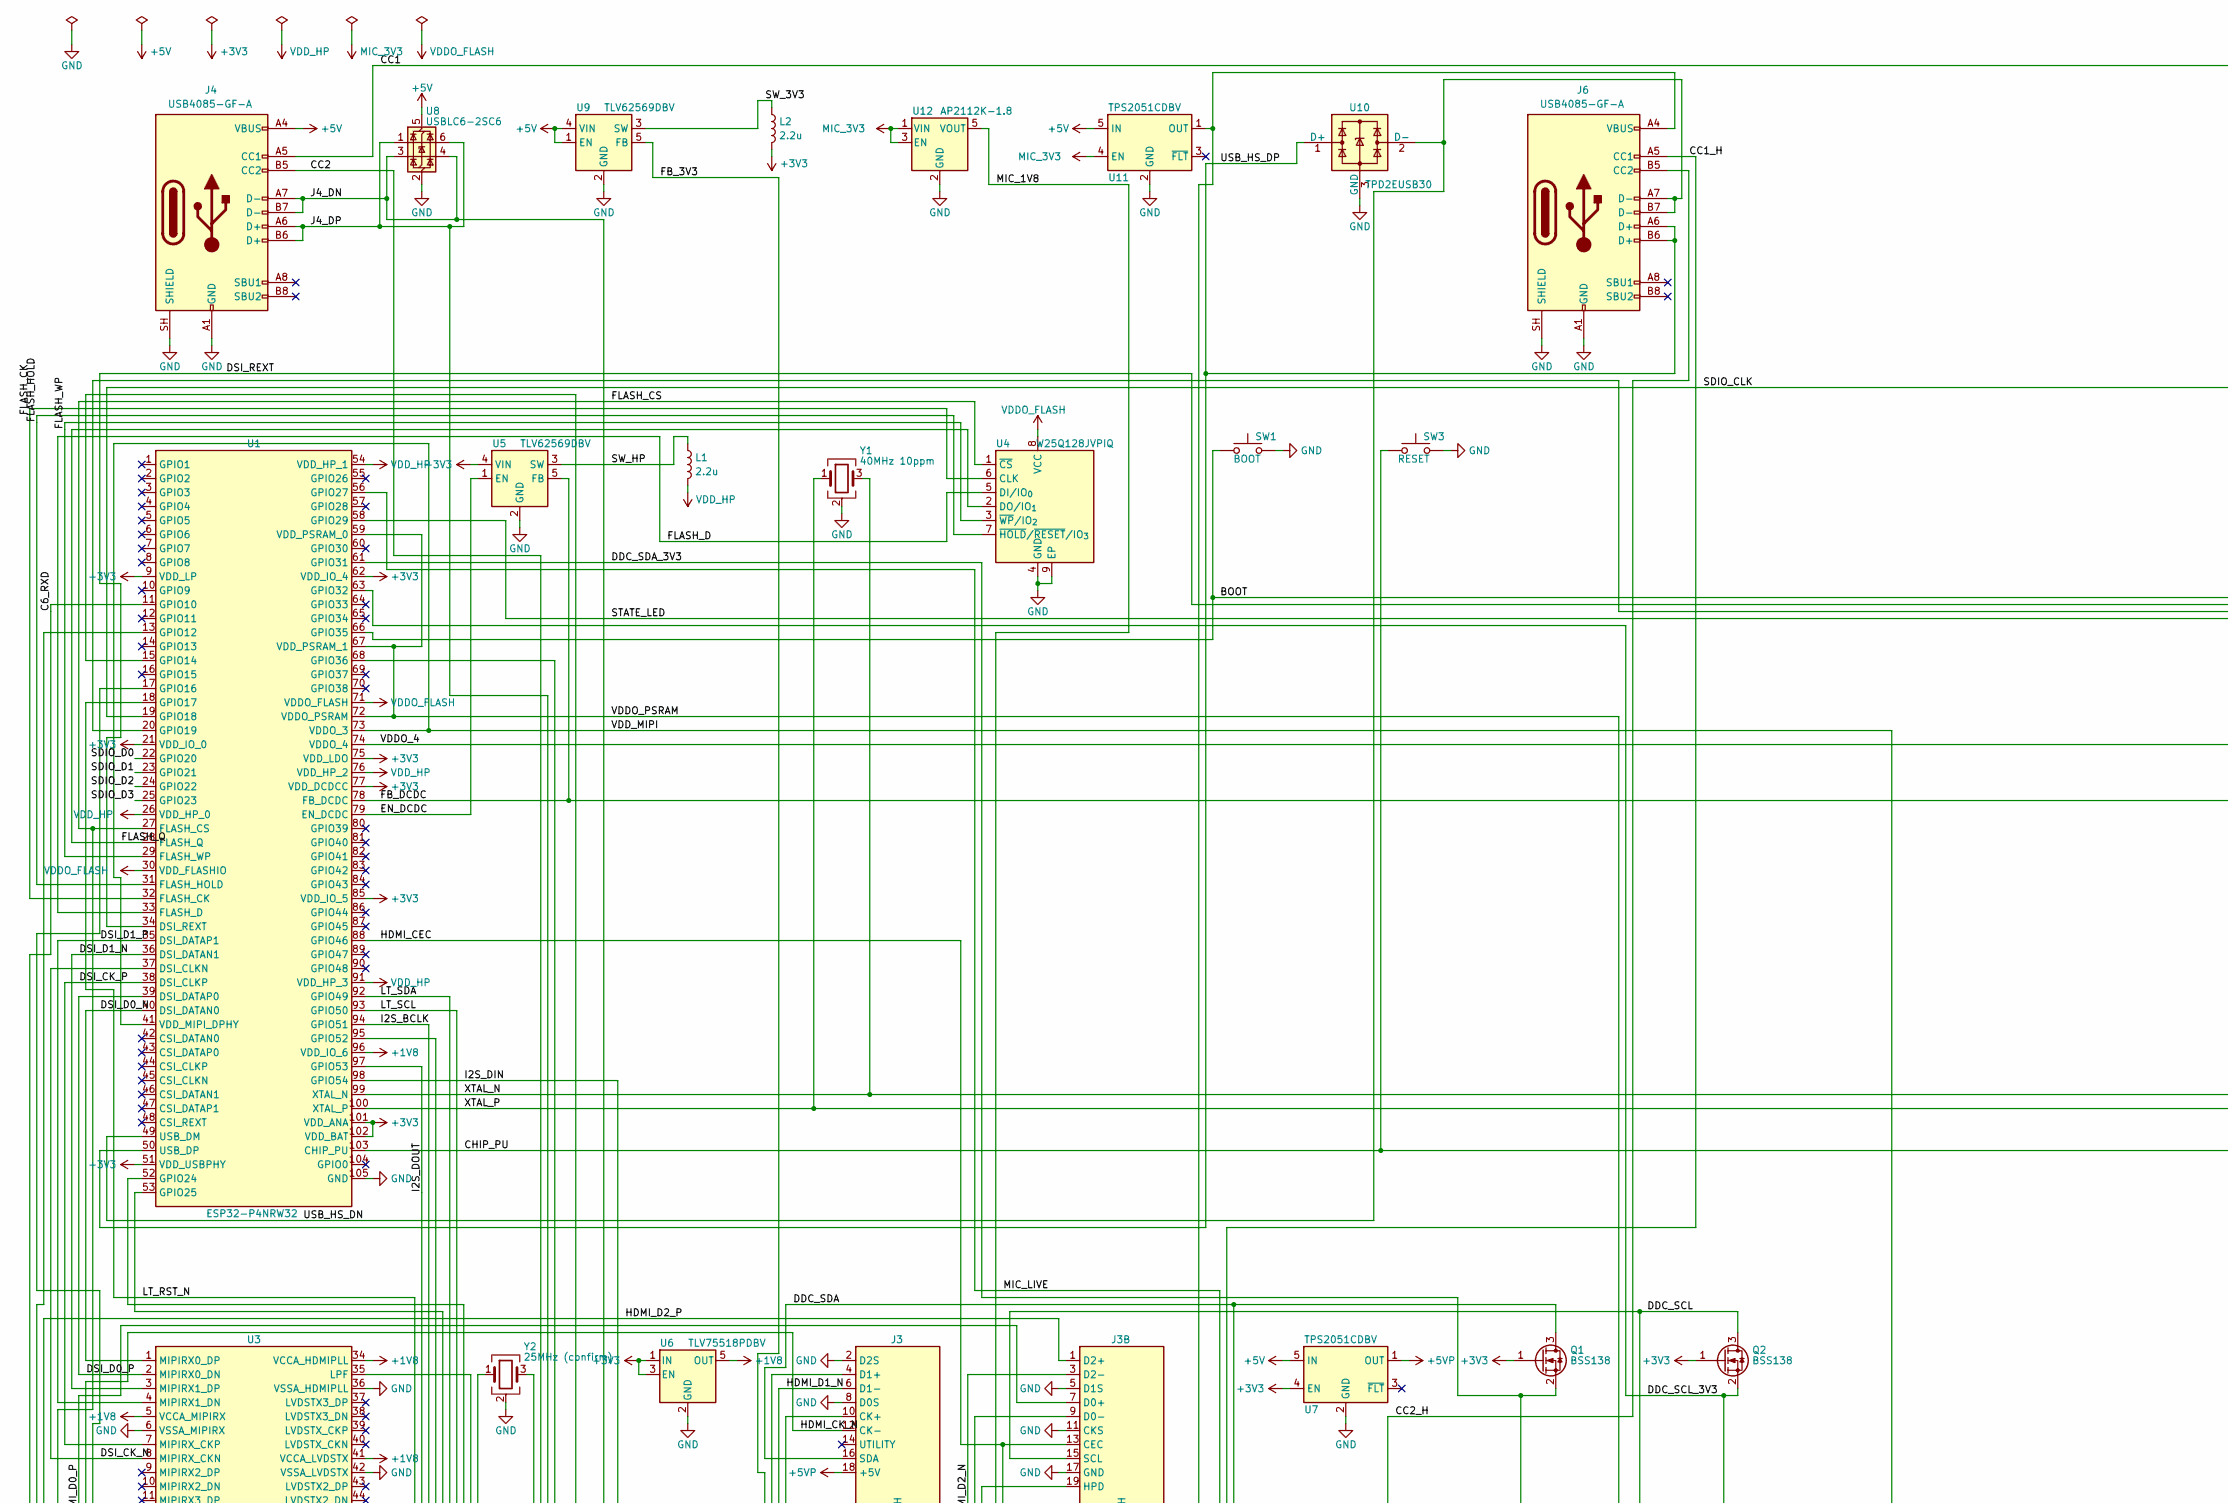
[picture p51: schematic agentcast_dongle.kicad_sch, part in row 1, column 1]

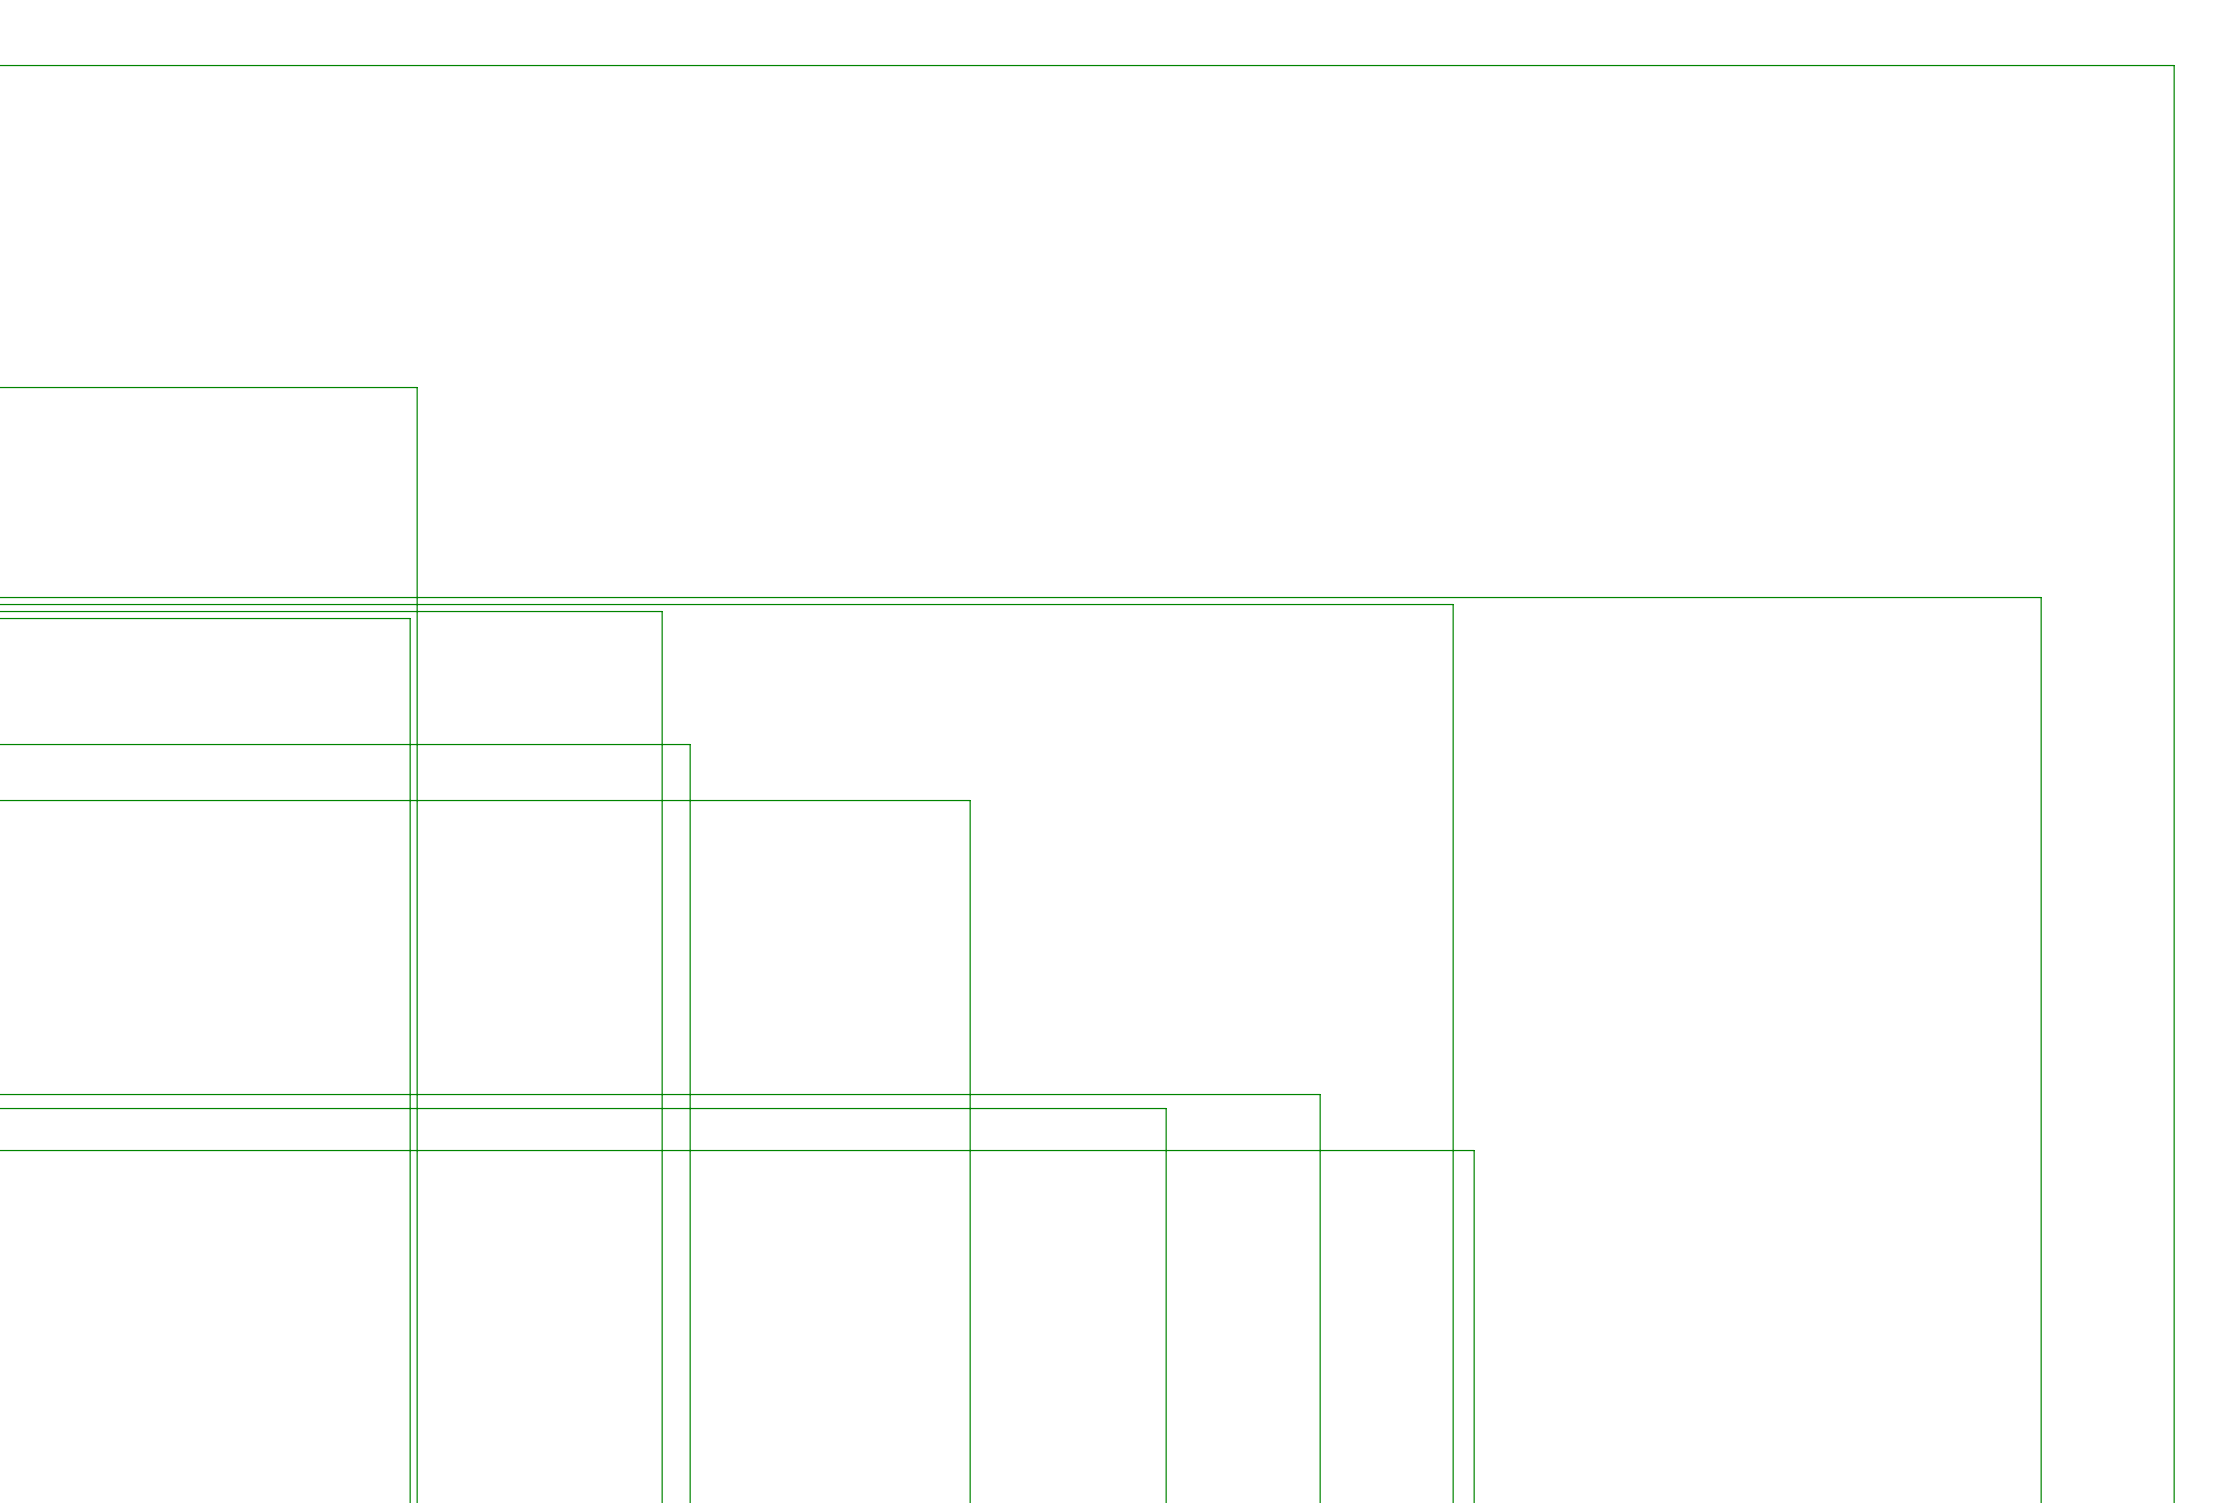
[picture p52: schematic agentcast_dongle.kicad_sch, part in row 1, column 2]

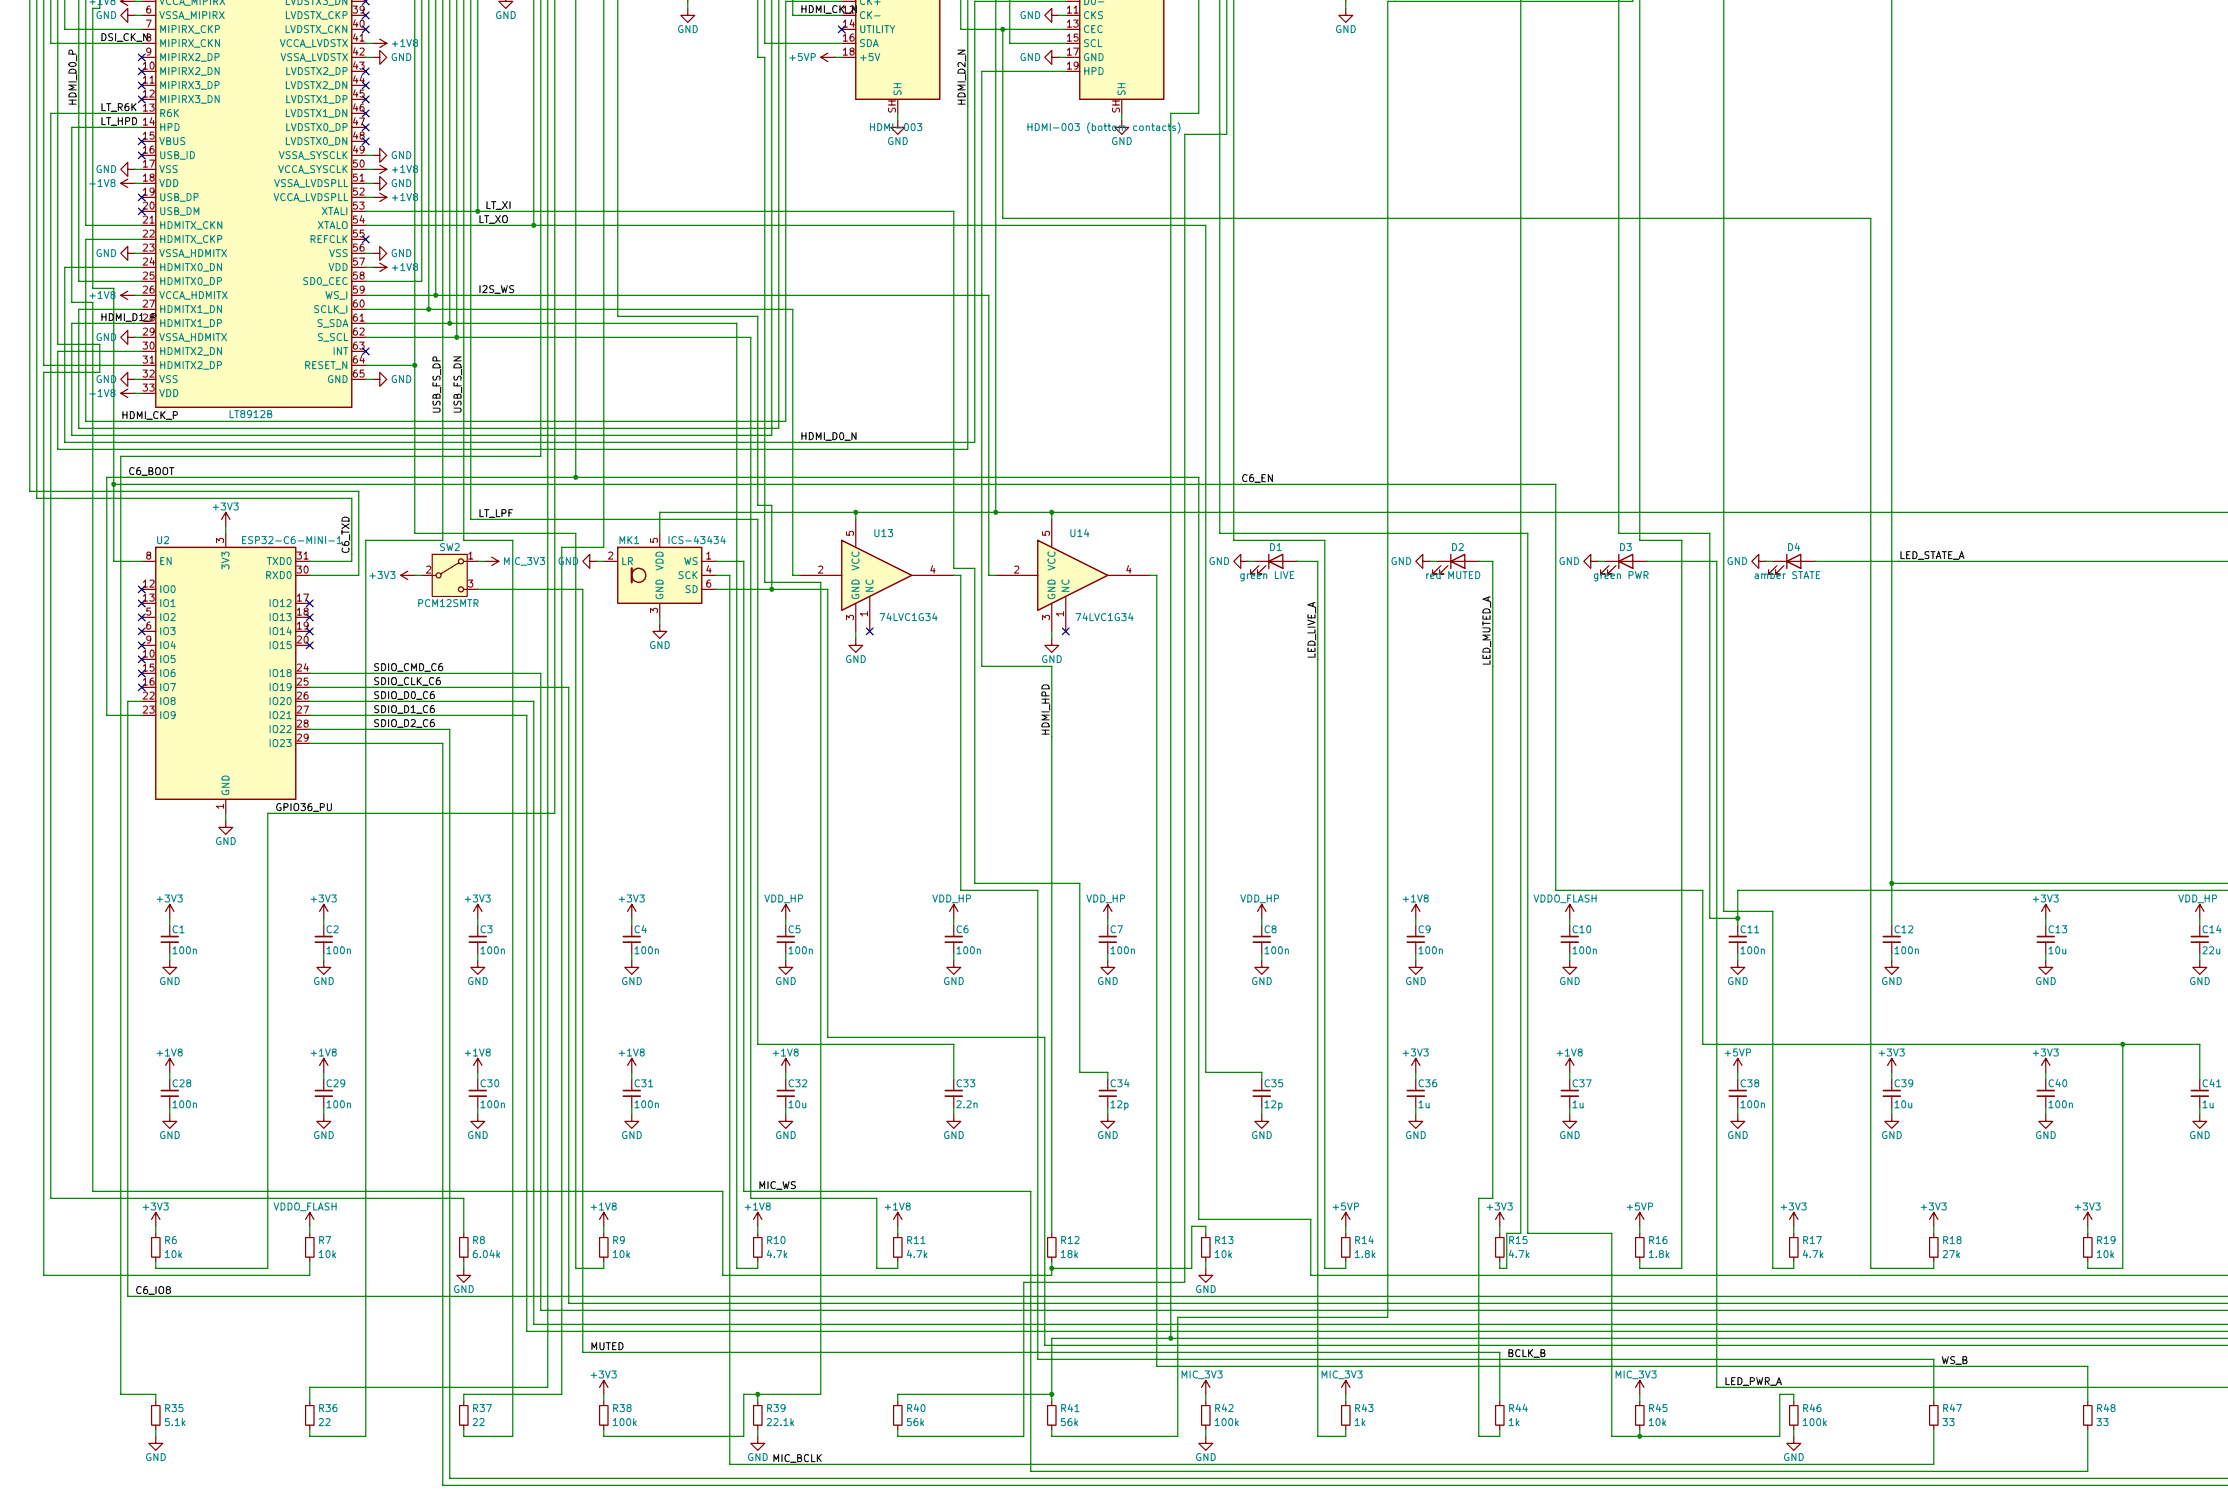
[picture p53: schematic agentcast_dongle.kicad_sch, part in row 2, column 1]

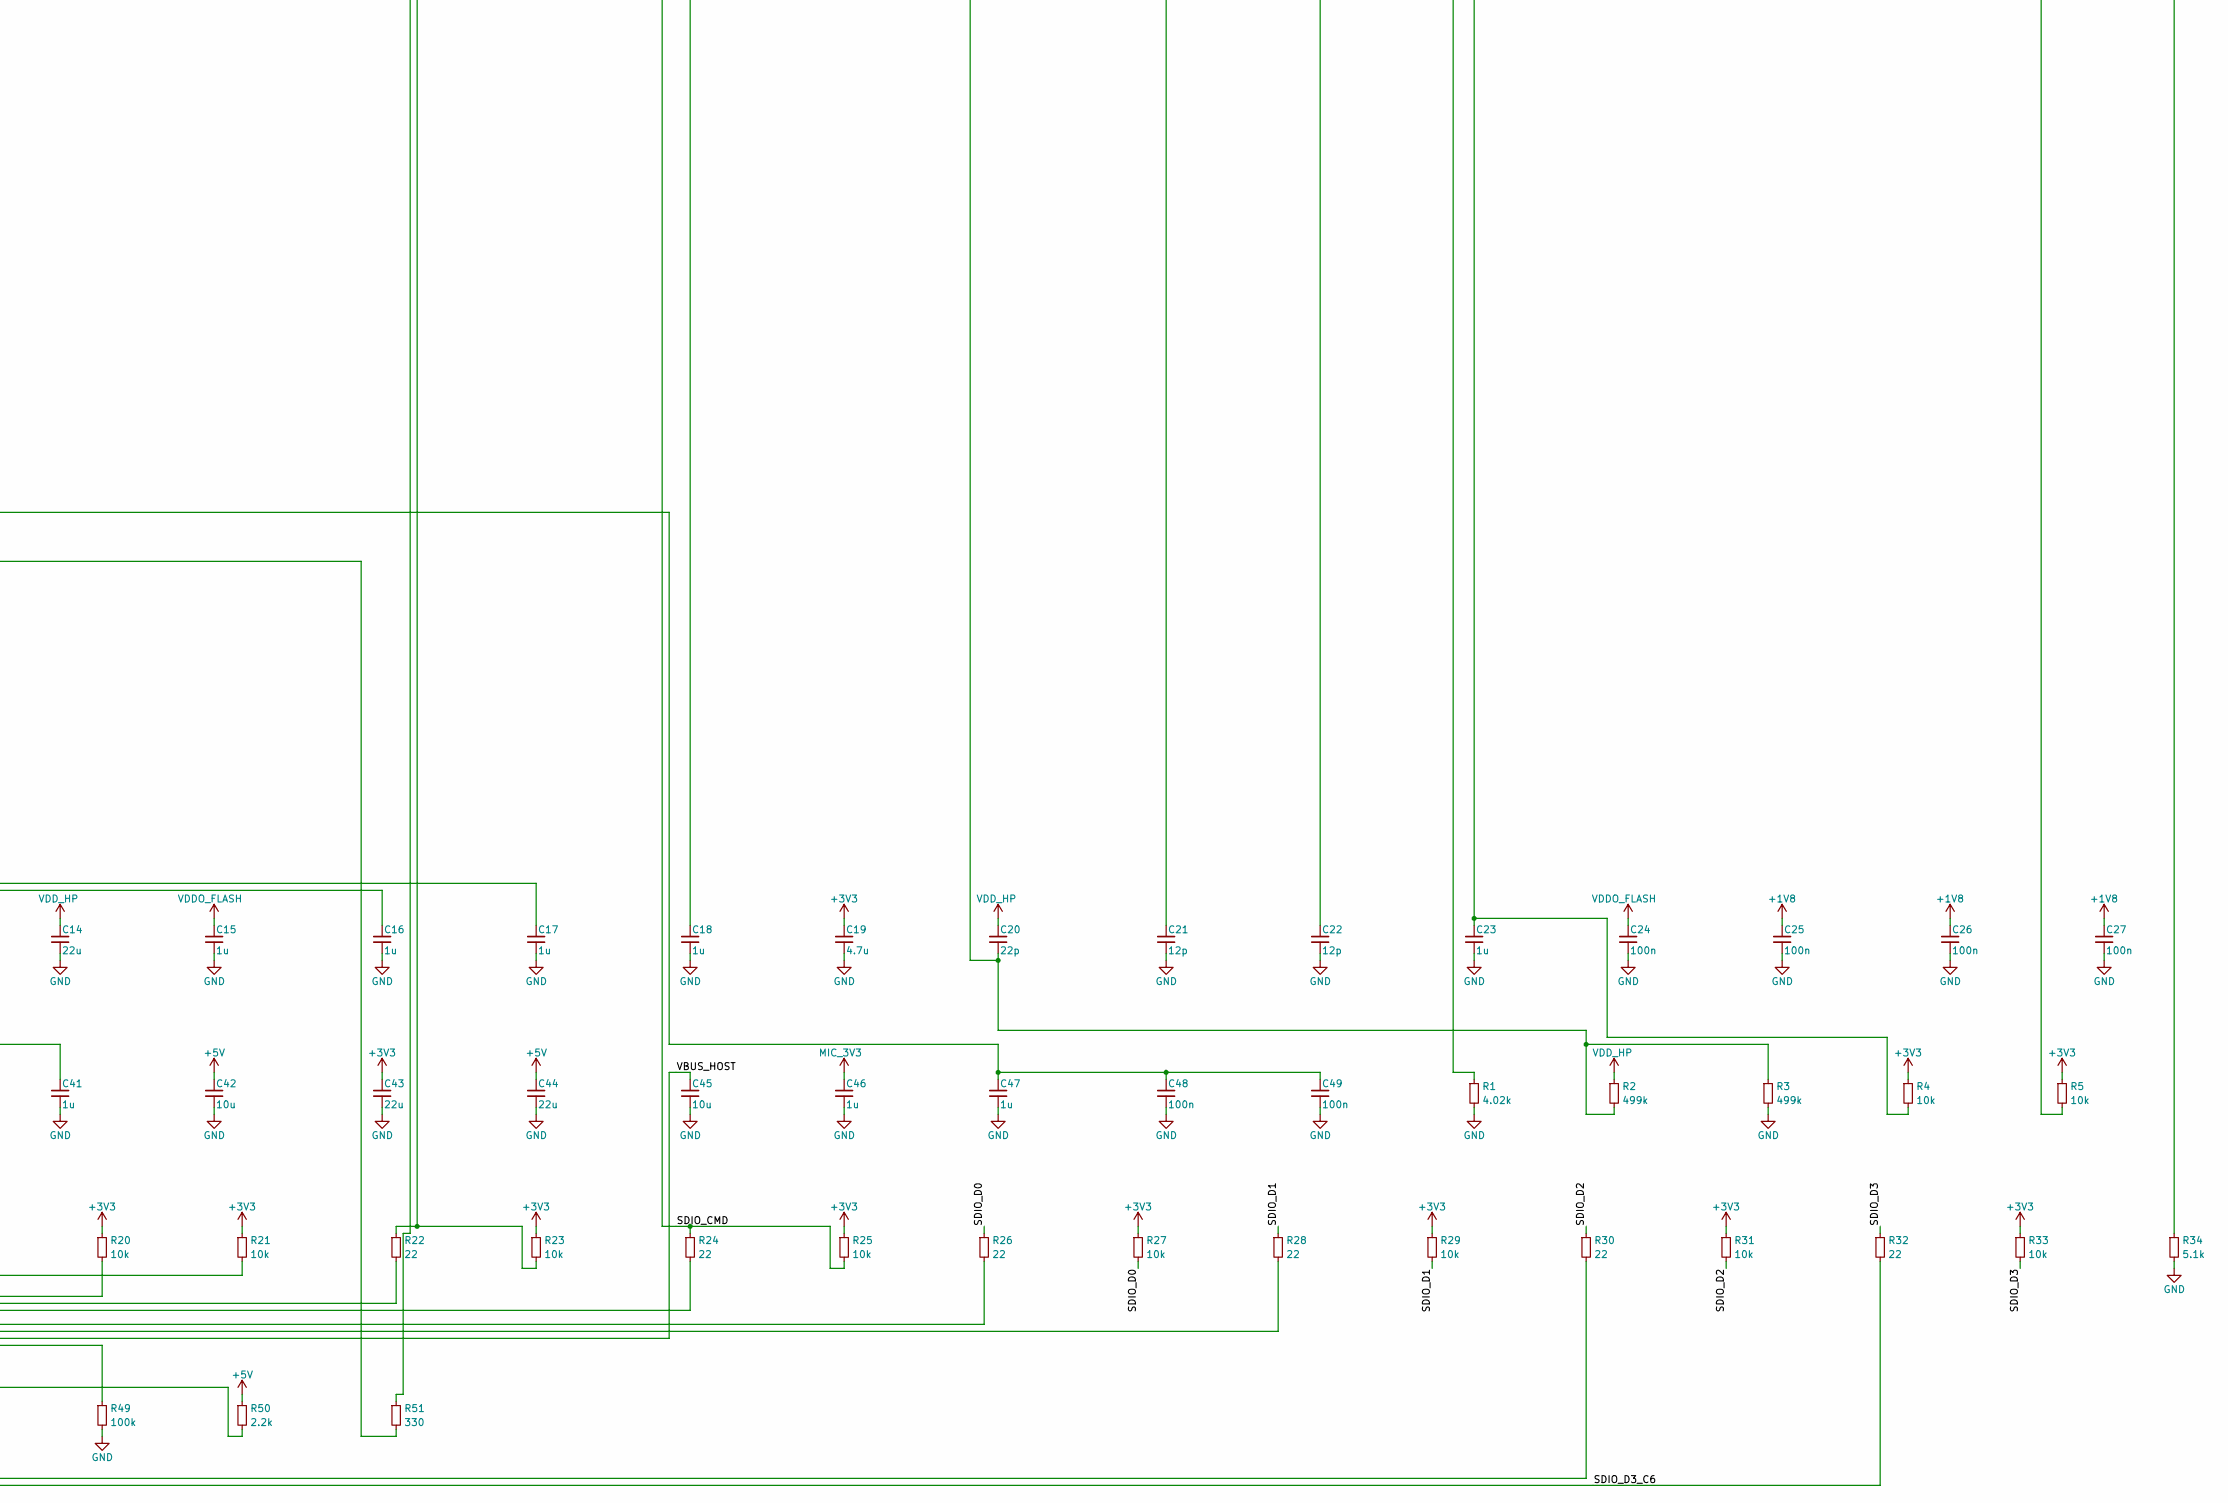
[picture p54: schematic agentcast_dongle.kicad_sch, part in row 2, column 2]

Parts:
C1, C2, C3, C4, C5, C6, C7, C8, C9, C10, C11, C12, C24, C25, C26, C27, C28, C29, C30, C31, C38, C40, C48, C49: 100n; C_0402_1005Metric
C13, C32, C39, C42, C45: 10u; C_0603_1608Metric
C14, C43, C44: 22u; C_0805_2012Metric
C15, C16, C17, C18, C23, C36, C37, C41, C46, C47: 1u; C_0402_1005Metric
C19: 4.7u; C_0603_1608Metric
C20: 22p; C_0402_1005Metric
C21, C22, C34, C35: 12p; C_0402_1005Metric
C33: 2.2n; C_0402_1005Metric
D1: green LIVE; LED_0603_1608Metric
D2: red MUTED; LED_0603_1608Metric
D3: green PWR; LED_0603_1608Metric
D4: amber STATE; LED_0603_1608Metric
J3: HDMI-003; HDMI_A_Plug_XUNPU_HDMI-003_Top
J3B: HDMI-003 (bottom contacts); HDMI_A_Plug_XUNPU_HDMI-003_Bottom
J4, J6: USB4085-GF-A; USB_C_Receptacle_GCT_USB4085
L1, L2: 2.2u; L_1008_2520Metric
MK1: ICS-43434; InvenSense_ICS-43434-6_3.5x2.65mm
Q1, Q2: BSS138; SOT-23
R1: 4.02k; R_0402_1005Metric
R2, R3: 499k; R_0402_1005Metric
R4, R5, R6, R7, R9, R13, R19, R20, R21, R23, R25, R27, R29, R31, R33, R45: 10k; R_0402_1005Metric
R8: 6.04k; R_0402_1005Metric
R10, R11, R15, R17: 4.7k; R_0402_1005Metric
R12: 18k; R_0402_1005Metric
R14, R16: 1.8k; R_0402_1005Metric
R18: 27k; R_0402_1005Metric
R22, R24, R26, R28, R30, R32, R36, R37: 22; R_0402_1005Metric
R34, R35: 5.1k; R_0402_1005Metric
R38, R42, R46, R49: 100k; R_0402_1005Metric
R39: 22.1k; R_0402_1005Metric
R40, R41: 56k; R_0402_1005Metric
R43, R44: 1k; R_0402_1005Metric
R47, R48: 33; R_0402_1005Metric
R50: 2.2k; R_0402_1005Metric
R51: 330; R_0402_1005Metric
SW1: BOOT; SW_SPST_B3U-1000P
SW2: PCM12SMTR; SW_SPDT_PCM12
SW3: RESET; SW_SPST_B3U-1000P
U1: ESP32-P4NRW32; QFN-104-1EP_10x10mm_P0.35mm_EP7.5x7.5mm
U2: ESP32-C6-MINI-1
U3: LT8912B; QFN-64-1EP_7.5x7.5mm_P0.4mm_EP6.2x6.2mm
U4: W25Q128JVPIQ; WSON-8-1EP_6x5mm_P1.27mm_EP3.4x4.3mm
U5, U9: TLV62569DBV; SOT-23-5
U6: TLV75518PDBV; SOT-23-5
U7, U11: TPS2051CDBV; SOT-23-5
U8: USBLC6-2SC6; SOT-23-6
U10: TPD2EUSB30; Texas_DRT-3
U12: AP2112K-1.8; SOT-23-5
U13, U14: 74LVC1G34; SOT-353_SC-70-5
Y1: 40MHz 10ppm; Crystal_SMD_3225-4Pin_3.2x2.5mm
Y2: 25MHz (confirm); Crystal_SMD_3225-4Pin_3.2x2.5mm

Connections:
+1V8: C9.1, C25.1, C26.1, C27.1, C28.1, C29.1, C30.1, C31.1, C32.1, C37.1, R9.1, R10.1, R11.1, U1.96 (VDD_IO_6), U3.5 (VCCA_MIPIRX), U3.18 (VDD), U3.26 (VCCA_HDMITX), U3.33 (VDD), U3.34 (VCCA_HDMIPLL), U3.41 (VCCA_LVDSTX), U3.50 (VCCA_SYSCLK), U3.52 (VCCA_LVDSPLL), U3.57 (VDD), U6.5 (OUT)
+3V3: C1.1, C2.1, C3.1, C4.1, C13.1, C19.1, C36.1, C39.1, C40.1, C43.1, L2.2, Q1.1 (G), Q2.1 (G), R4.1, R5.1, R6.1, R15.1, R17.1, R18.1, R19.1, R20.1, R21.1, R23.1, R25.1, R27.1, R29.1, R31.1, R33.1, R38.1, SW2.2 (B), U1.9 (VDD_LP), U1.21 (VDD_IO_0), U1.51 (VDD_USBPHY), U1.62 (VDD_IO_4), U1.75 (VDD_LDO), U1.77 (VDD_DCDCC), U1.85 (VDD_IO_5), U1.101 (VDD_ANA), U1.102 (VDD_BAT), U2.3 (3V3), U5.4 (VIN), U6.1 (IN), U6.3 (EN), U7.4 (EN)
+5V: C42.1, C44.1, J4.A4 (VBUS), J4.A9 (VBUS), J4.B4 (VBUS), J4.B9 (VBUS), R50.1, U7.5 (IN), U8.5 (VBUS), U9.1 (EN), U9.4 (VIN), U11.5 (IN)
+5VP: C38.1, J3.18 (+5V), R14.1, R16.1, U7.1 (OUT)
/BCLK_B: R47.1, U13.4
/BOOT: R5.2, SW1.1, U1.66 (GPIO35)
/C6_BOOT: R21.2, U1.15 (GPIO14), U2.23 (IO9)
/C6_EN: C41.1, R19.2, U1.17 (GPIO16), U2.8 (EN)
/C6_IO8: R20.2, U2.22 (IO8)
/C6_RXD: U1.11 (GPIO10), U2.30 (RXD0)
/C6_TXD: U1.13 (GPIO12), U2.31 (TXD0)
/CC1: J4.A5 (CC1), R34.1
/CC1_H: J6.A5 (CC1), R40.2
/CC2: J4.B5 (CC2), R35.1
/CC2_H: J6.B5 (CC2), R41.2
/CHIP_PU: C23.1, R4.2, SW3.1, U1.103 (CHIP_PU)
/DDC_SCL: J3B.15 (SCL), Q2.3 (D), R16.2
/DDC_SCL_3V3: Q2.2 (S), R17.2, U1.63 (GPIO32)
/DDC_SDA: J3.16 (SDA), Q1.3 (D), R14.2
/DDC_SDA_3V3: Q1.2 (S), R15.2, U1.61 (GPIO31)
/DSI_CK_N: U1.37 (DSI_CLKN), U3.8 (MIPIRX_CKN)
/DSI_CK_P: U1.38 (DSI_CLKP), U3.7 (MIPIRX_CKP)
/DSI_D0_N: U1.40 (DSI_DATAN0), U3.1 (MIPIRX0_DP)
/DSI_D0_P: U1.39 (DSI_DATAP0), U3.2 (MIPIRX0_DN)
/DSI_D1_N: U1.36 (DSI_DATAN1), U3.3 (MIPIRX1_DP)
/DSI_D1_P: U1.35 (DSI_DATAP1), U3.4 (MIPIRX1_DN)
/DSI_REXT: R1.1, U1.34 (DSI_REXT)
/EN_DCDC: U1.79 (EN_DCDC), U5.1 (EN)
/FB_3V3: R38.2, R39.1, U9.5 (FB)
/FB_DCDC: C20.2, R2.2, R3.1, U1.78 (FB_DCDC), U5.5 (FB)
/FLASH_CK: U1.32 (FLASH_CK), U4.6 (CLK)
/FLASH_CS: R7.2, U1.27 (FLASH_CS), U4.1 (~CS)
/FLASH_D: U1.33 (FLASH_D), U4.5 (DI/IO_{0})
/FLASH_HOLD: U1.31 (FLASH_HOLD), U4.7 (~HOLD/~RESET/IO_{3})
/FLASH_Q: U1.28 (FLASH_Q), U4.2 (DO/IO_{1})
/FLASH_WP: U1.29 (FLASH_WP), U4.3 (~WP/IO_{2})
/GPIO36_PU: R6.2, U1.68 (GPIO36)
/HDMI_CEC: J3B.13 (CEC), R18.2, U1.88 (GPIO46)
/HDMI_CK_N: J3.12 (CK-), U3.21 (HDMITX_CKN)
/HDMI_CK_P: J3.10 (CK+), U3.22 (HDMITX_CKP)
/HDMI_D0_N: J3B.9 (D0-), U3.24 (HDMITX0_DN)
/HDMI_D0_P: J3B.7 (D0+), U3.25 (HDMITX0_DP)
/HDMI_D1_N: J3.6 (D1-), U3.27 (HDMITX1_DN)
/HDMI_D1_P: J3.4 (D1+), U3.28 (HDMITX1_DP)
/HDMI_D2_N: J3B.3 (D2-), U3.30 (HDMITX2_DN)
/HDMI_D2_P: J3B.1 (D2+), U3.31 (HDMITX2_DP)
/HDMI_HPD: J3B.19 (HPD), R12.1
/I2S_BCLK: U1.94 (GPIO51), U3.60 (SCLK_I), U13.2
/I2S_DIN: MK1.6 (SD), R49.1, U1.98 (GPIO54)
/I2S_DOUT: U1.97 (GPIO53), U3.58 (SD0_CEC)
/I2S_WS: U1.95 (GPIO52), U3.59 (WS_I), U14.2
/J4_DN: J4.A7 (D-), J4.B7 (D-), R37.1, U8.3 (I/O2), U8.4 (I/O2)
/J4_DP: J4.A6 (D+), J4.B6 (D+), R36.1, U8.1 (I/O1), U8.6 (I/O1)
/LED_LIVE_A: D1.2 (A), R43.2
/LED_MUTED_A: D2.2 (A), R44.2
/LED_PWR_A: D3.2 (A), R50.2
/LED_STATE_A: D4.2 (A), R51.2
/LT_HPD: R12.2, R13.1, U3.14 (HPD)
/LT_LPF: C33.1, U3.35 (LPF)
/LT_R6K: R8.1, U3.13 (R6K)
/LT_RST_N: R9.2, U1.18 (GPIO17), U3.64 (RESET_N)
/LT_SCL: R11.2, U1.93 (GPIO50), U3.62 (S_SCL)
/LT_SDA: R10.2, U1.92 (GPIO49), U3.61 (S_SDA)
/LT_XI: C34.1, U3.53 (XTALI), Y2.1
/LT_XO: C35.1, U3.54 (XTALO), Y2.3
/MIC_1V8: C47.1, C48.1, C49.1, MK1.5 (VDD), U12.5 (VOUT), U13.5 (VCC), U14.5 (VCC)
/MIC_BCLK: MK1.4 (SCK), R47.2
/MIC_LIVE: R45.2, R46.1, U1.56 (GPIO27)
/MIC_WS: MK1.1 (WS), R48.2
/MUTED: R44.1, SW2.3 (C)
/SDIO_CLK: R22.1, R23.2, U1.19 (GPIO18)
/SDIO_CLK_C6: R22.2, U2.25 (IO19)
/SDIO_CMD: R24.1, R25.2, U1.20 (GPIO19)
/SDIO_CMD_C6: R24.2, U2.24 (IO18)
/SDIO_D0: R26.1, R27.2, U1.22 (GPIO20)
/SDIO_D0_C6: R26.2, U2.26 (IO20)
/SDIO_D1: R28.1, R29.2, U1.23 (GPIO21)
/SDIO_D1_C6: R28.2, U2.27 (IO21)
/SDIO_D2: R30.1, R31.2, U1.24 (GPIO22)
/SDIO_D2_C6: R30.2, U2.28 (IO22)
/SDIO_D3: R32.1, R33.2, U1.25 (GPIO23)
/SDIO_D3_C6: R32.2, U2.29 (IO23)
/STATE_LED: R51.1, U1.58 (GPIO29)
/SW_3V3: L2.1, U9.3 (SW)
/SW_HP: L1.1, U5.3 (SW)
/USB_FS_DN: R37.2, U1.52 (GPIO24)
/USB_FS_DP: R36.2, U1.53 (GPIO25)
/USB_HS_DN: J6.A7 (D-), J6.B7 (D-), U1.49 (USB_DM), U10.2 (D-)
/USB_HS_DP: J6.A6 (D+), J6.B6 (D+), U1.50 (USB_DP), U10.1 (D+)
/VBUS_HOST: C45.1, J6.A4 (VBUS), J6.A9 (VBUS), J6.B4 (VBUS), J6.B9 (VBUS), R40.1, R41.1, U11.1 (OUT)
/VDDO_4: C18.1, U1.74 (VDDO_4)
/VDDO_PSRAM: C11.1, C16.1, U1.59 (VDD_PSRAM_0), U1.67 (VDD_PSRAM_1), U1.72 (VDDO_PSRAM)
/VDD_MIPI: C12.1, C17.1, U1.41 (VDD_MIPI_DPHY), U1.73 (VDDO_3)
/WS_B: R48.1, U14.4
/XTAL_N: C22.1, U1.99 (XTAL_N), Y1.3
/XTAL_P: C21.1, U1.100 (XTAL_P), Y1.1
GND: C1.2, C2.2, C3.2, C4.2, C5.2, C6.2, C7.2, C8.2, C9.2, C10.2, C11.2, C12.2, C13.2, C14.2, C15.2, C16.2, C17.2, C18.2, C19.2, C21.2, C22.2, C23.2, C24.2, C25.2, C26.2, C27.2, C28.2, C29.2, C30.2, C31.2, C32.2, C33.2, C34.2, C35.2, C36.2, C37.2, C38.2, C39.2, C40.2, C41.2, C42.2, C43.2, C44.2, C45.2, C46.2, C47.2, C48.2, C49.2, D1.1 (K), D2.1 (K), D3.1 (K), D4.1 (K), J3.2 (D2S), J3.8 (D0S), J3.SH, J3B.5 (D1S), J3B.11 (CKS), J3B.17 (GND), J3B.SH, J4.A1 (GND), J4.A12 (GND), J4.B1 (GND), J4.B12 (GND), J4.SH (SHIELD), J6.A1 (GND), J6.A12 (GND), J6.B1 (GND), J6.B12 (GND), J6.SH (SHIELD), MK1.2 (LR), MK1.3 (GND), R1.2, R3.2, R8.2, R13.2, R34.2, R35.2, R39.2, R42.2, R46.2, R49.2, SW1.2, SW3.2, U1.105 (GND), U2.1 (GND), U2.2 (GND), U2.11 (GND), U2.14 (GND), U2.36 (GND), U2.37 (GND), U2.38 (GND), U2.39 (GND), U2.40 (GND), U2.41 (GND), U2.42 (GND), U2.43 (GND), U2.44 (GND), U2.45 (GND), U2.46 (GND), U2.47 (GND), U2.48 (GND), U2.49 (GND), U2.50 (GND), U2.51 (GND), U2.52 (GND), U2.53 (GND), U3.6 (VSSA_MIPIRX), U3.17 (VSS), U3.23 (VSSA_HDMITX), U3.29 (VSSA_HDMITX), U3.32 (VSS), U3.36 (VSSA_HDMIPLL), U3.42 (VSSA_LVDSTX), U3.49 (VSSA_SYSCLK), U3.51 (VSSA_LVDSPLL), U3.56 (VSS), U3.65 (GND), U4.4 (GND), U4.9 (EP), U5.2 (GND), U6.2 (GND), U7.2 (GND), U8.2 (GND), U9.2 (GND), U10.3 (GND), U11.2 (GND), U12.2 (GND), U13.3 (GND), U14.3 (GND), Y1.2 (G), Y1.4 (G), Y2.2 (G), Y2.4 (G)
MIC_3V3: C46.1, R42.1, R43.1, R45.1, SW2.1 (A), U11.4 (EN), U12.1 (VIN), U12.3 (EN)
VDDO_FLASH: C10.1, C15.1, C24.1, R7.1, U1.30 (VDD_FLASHIO), U1.71 (VDDO_FLASH), U4.8 (VCC)
VDD_HP: C5.1, C6.1, C7.1, C8.1, C14.1, C20.1, L1.2, R2.1, U1.26 (VDD_HP_0), U1.54 (VDD_HP_1), U1.76 (VDD_HP_2), U1.91 (VDD_HP_3)

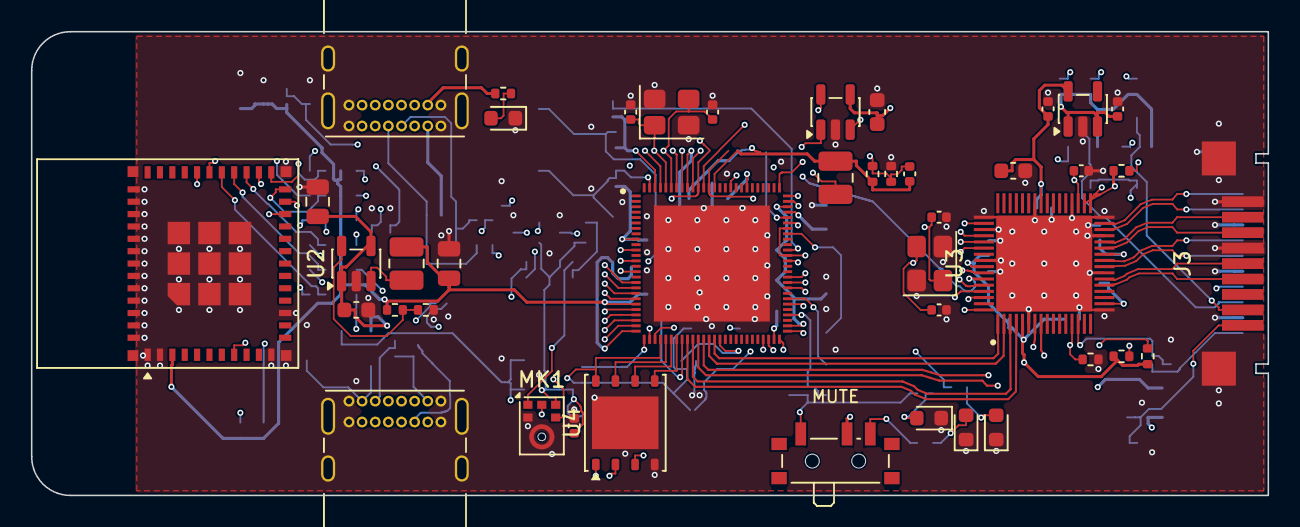
[picture p55: board hardware/v0.5/dongle/agentcast_dongle.kicad_pcb from above]

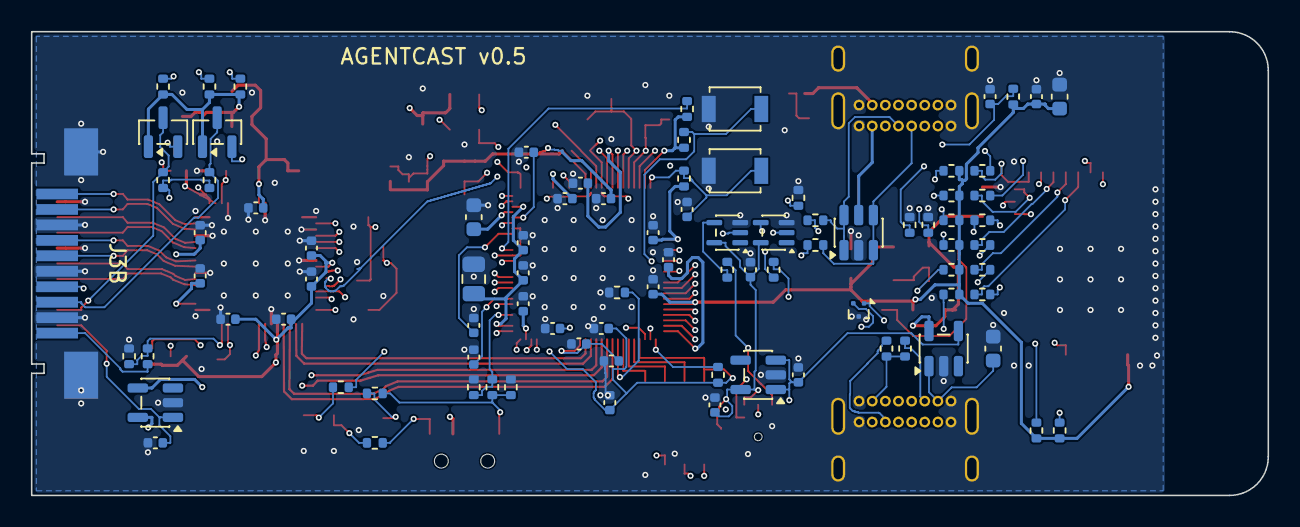
[picture p56: board hardware/v0.5/dongle/agentcast_dongle.kicad_pcb from below]

Board: 8 copper layers, 80.0 x 30.0 mm, 132 parts (89 on the bottom side), 100 nets.
