ThyFriendlyFox/agentcast-prototype/hardware/v0.4/dongle/agentcast_dongle.kicad_pcb

## KiCad design hardware/v0.4/dongle/agentcast_dongle.kicad_pcb (2026-11-05, an earlier design)

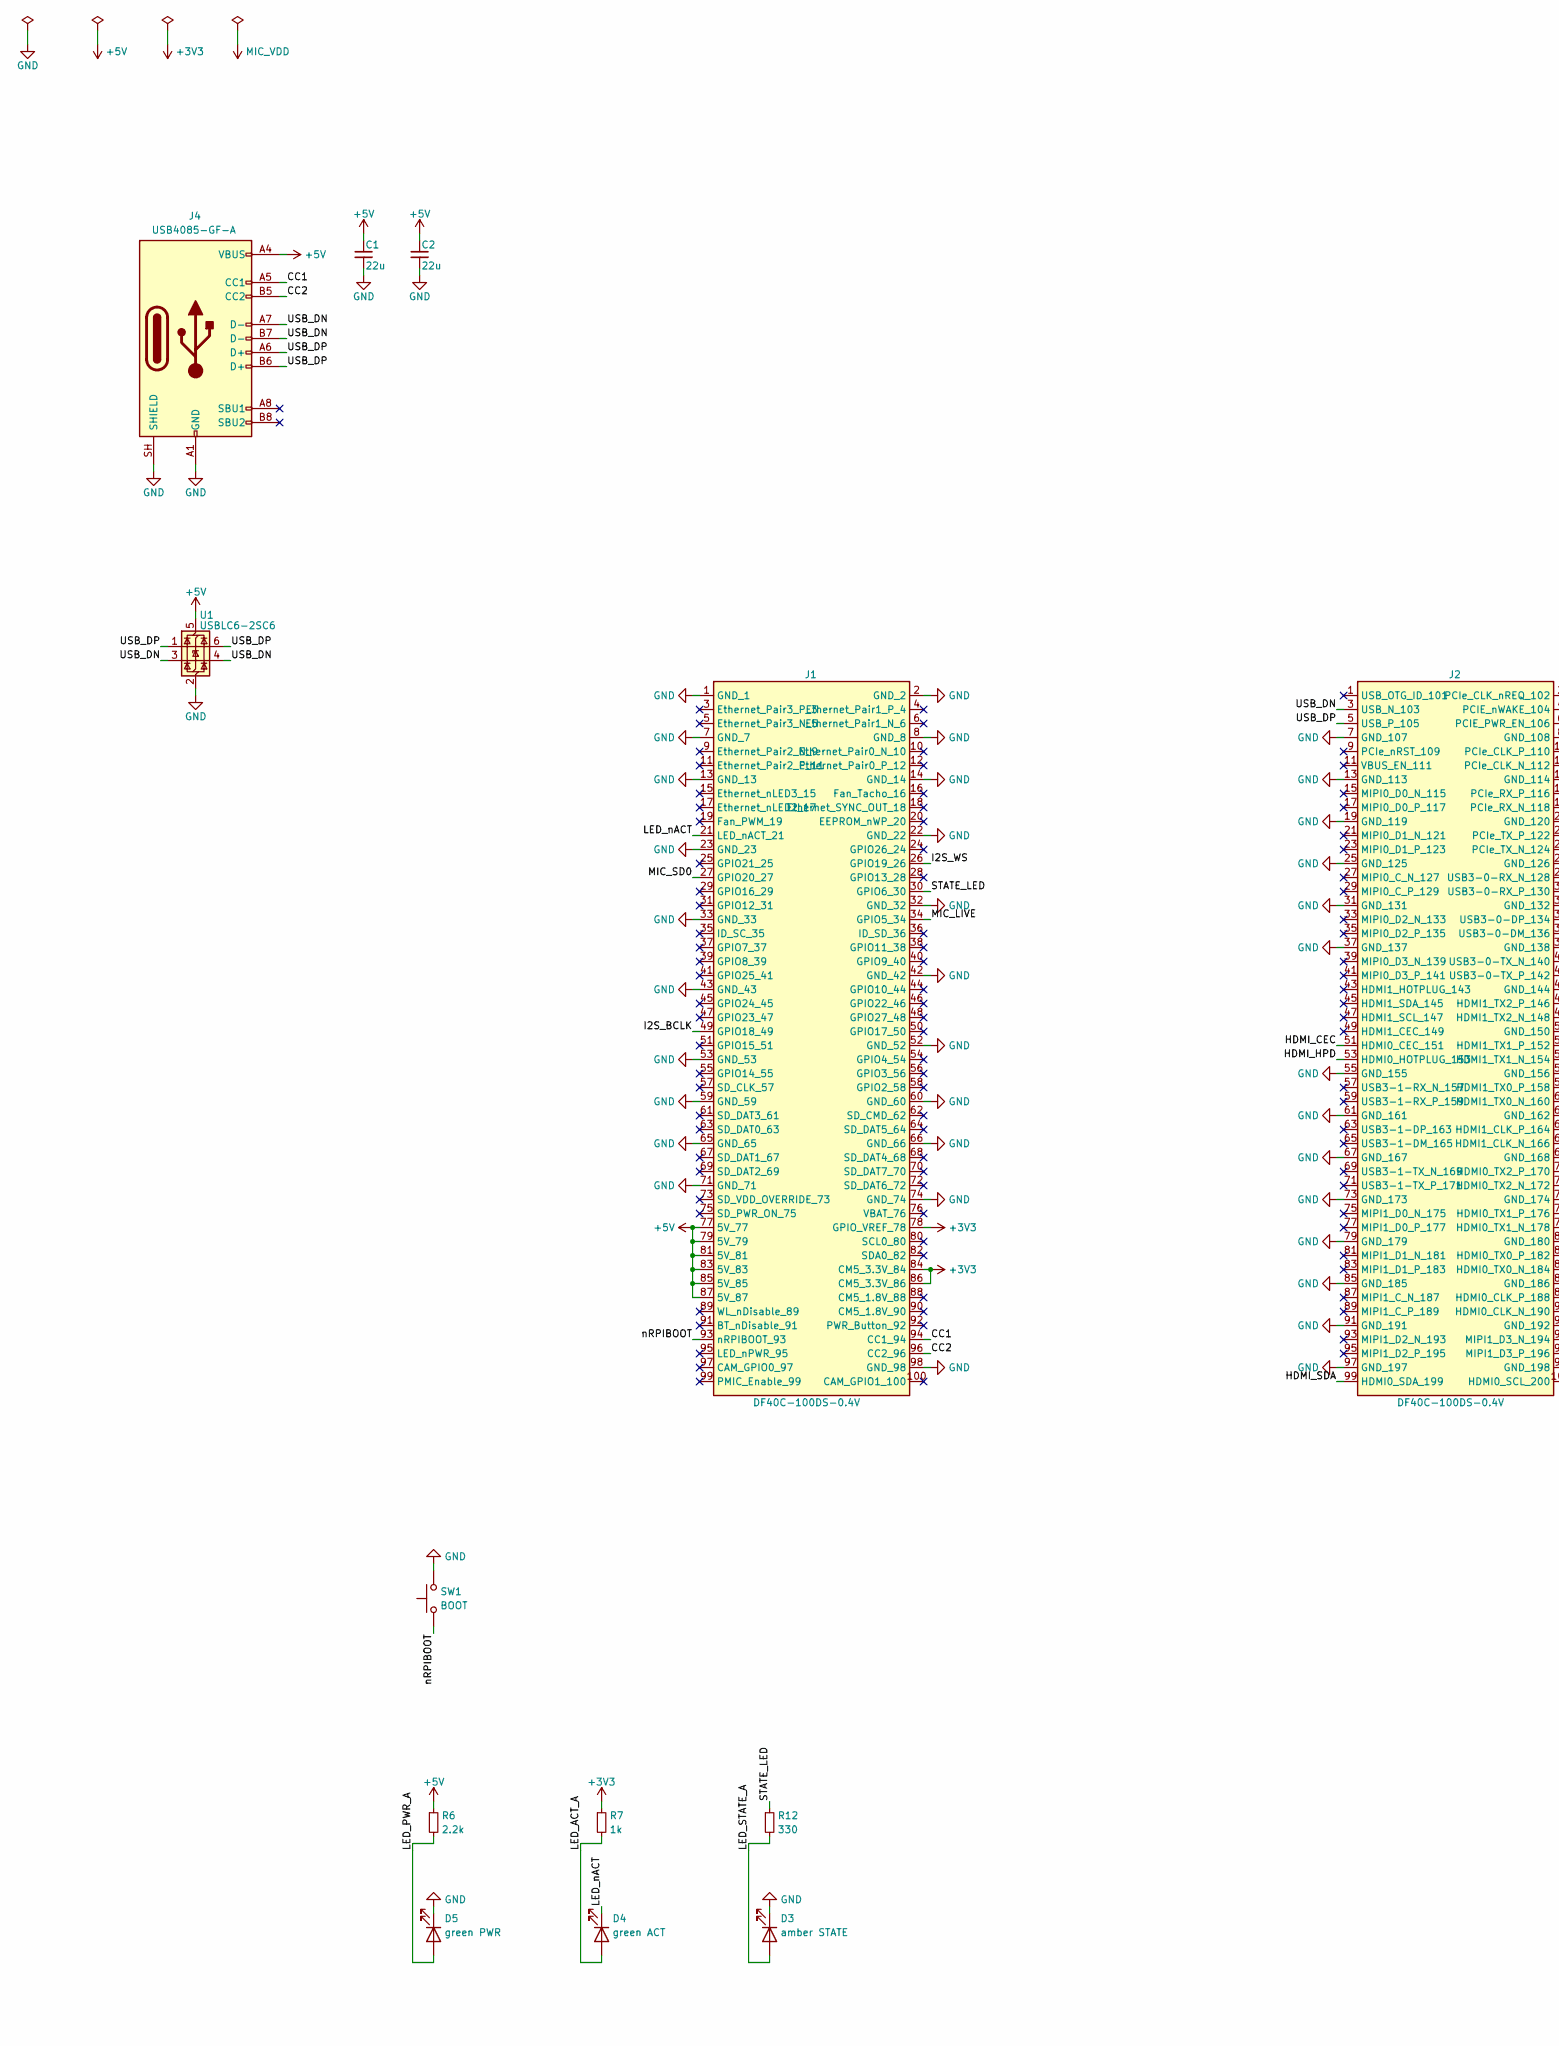
[picture p57: schematic agentcast_dongle.kicad_sch, part in row 1, column 1]

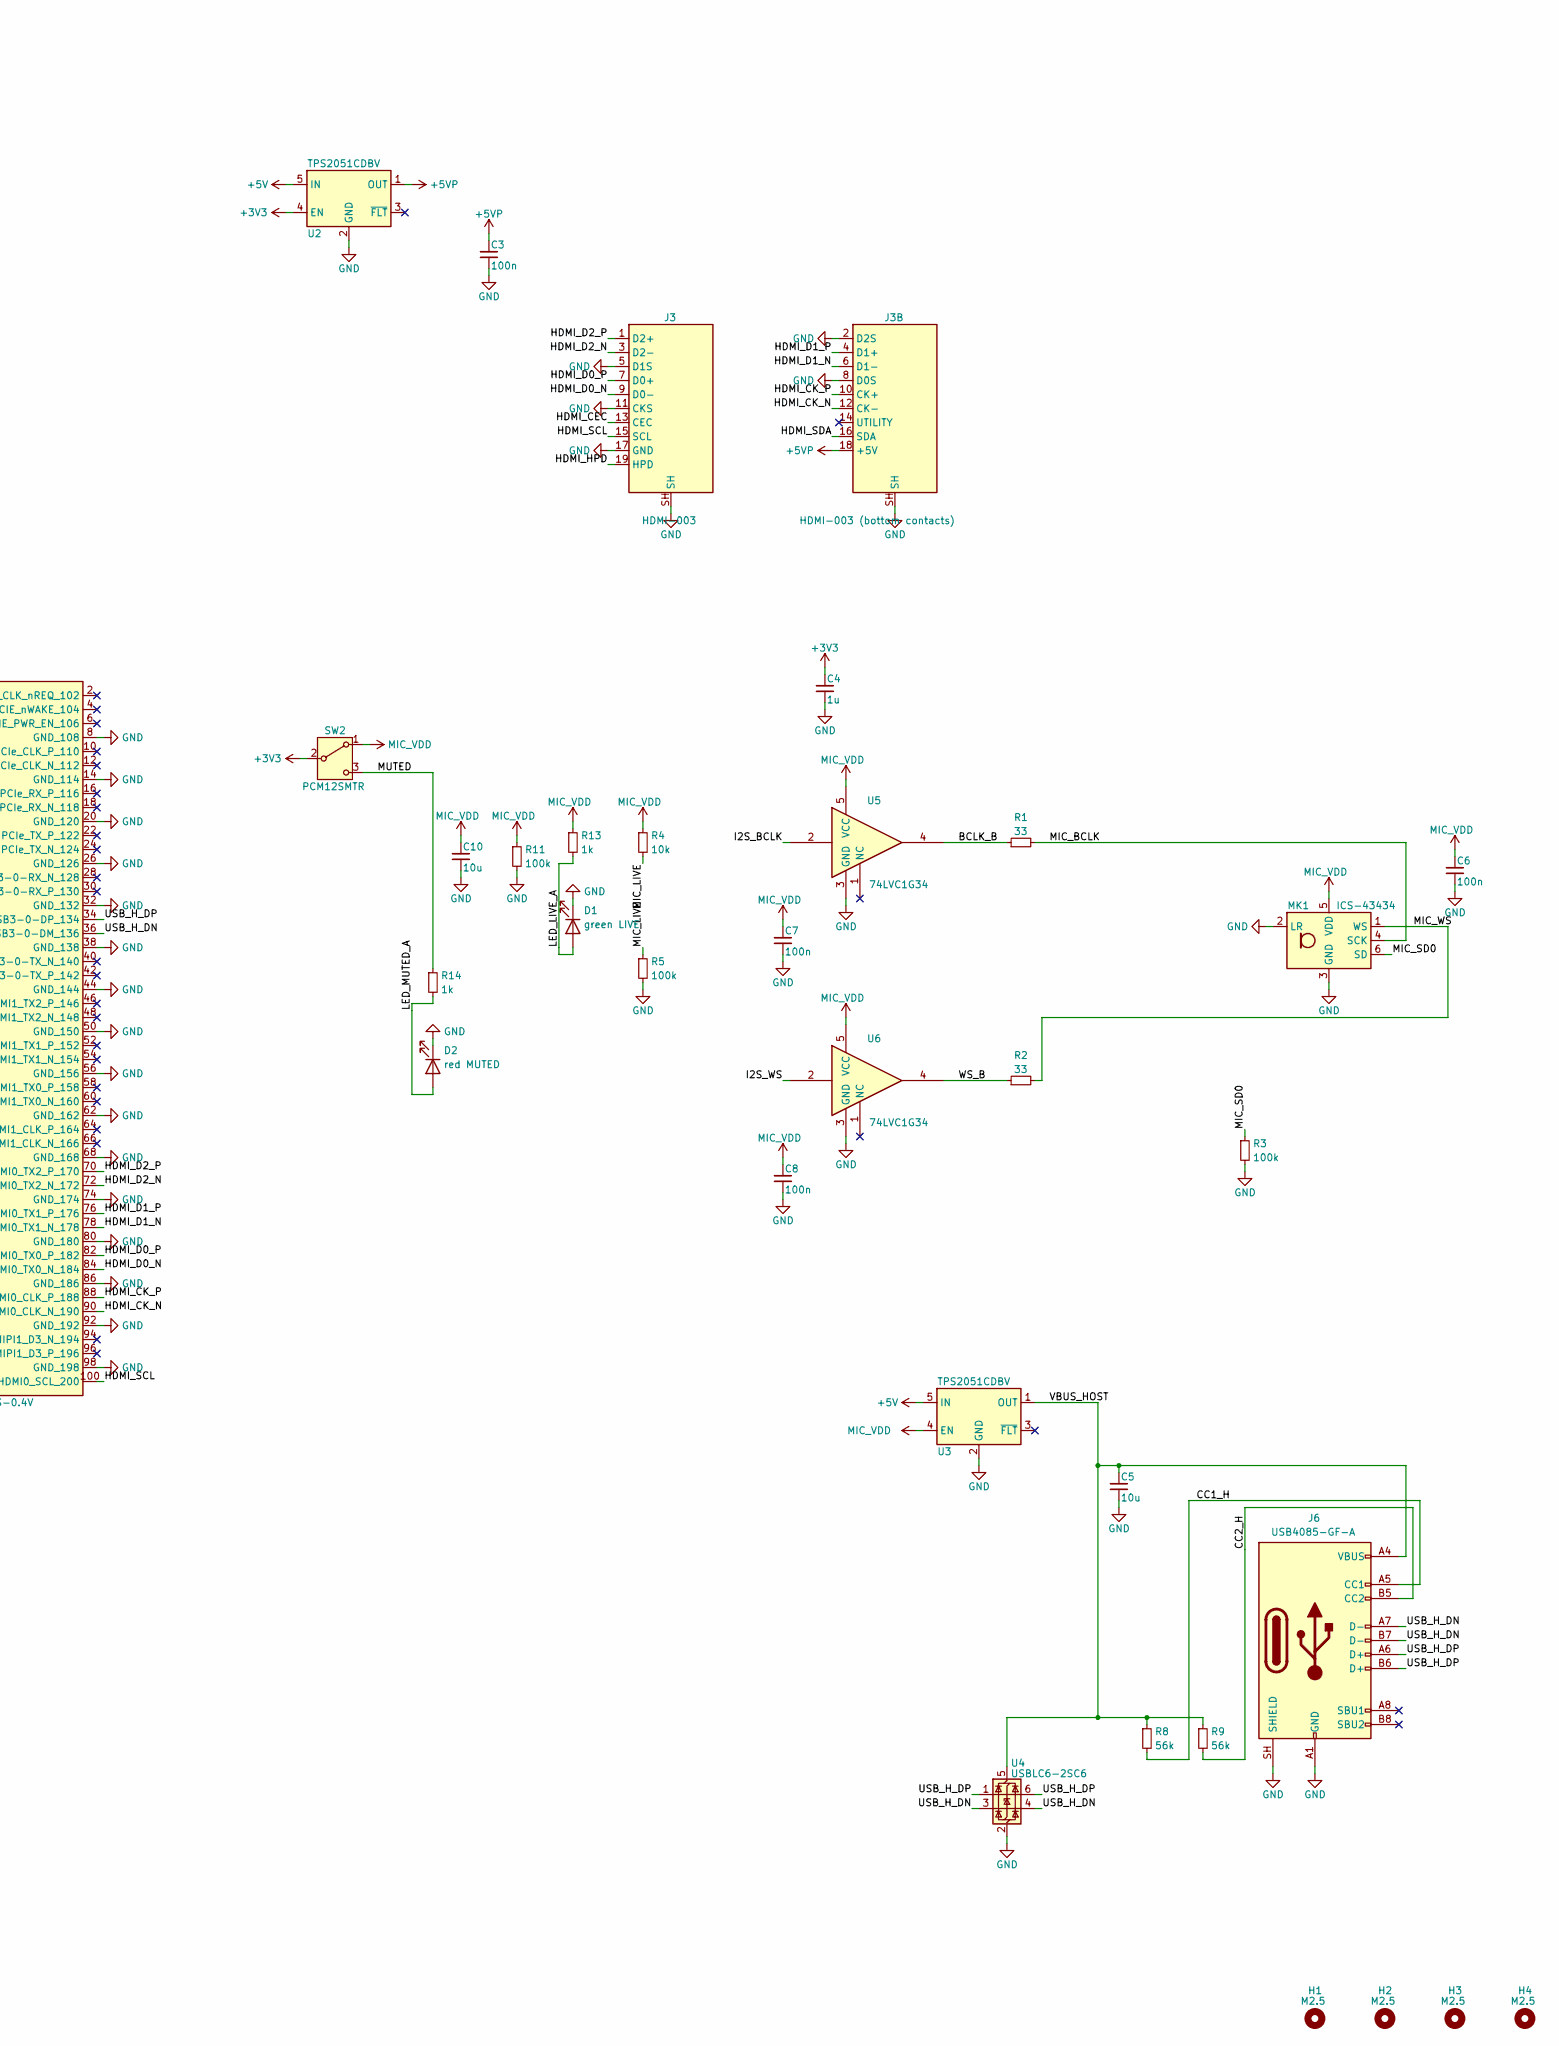
[picture p58: schematic agentcast_dongle.kicad_sch, part in row 1, column 2]

Parts:
C1, C2: 22u; C_0805_2012Metric
C3, C6, C7, C8: 100n; C_0402_1005Metric
C4: 1u; C_0402_1005Metric
C5: 10u; C_0805_2012Metric
C10: 10u; C_0603_1608Metric
D1: green LIVE; LED_0603_1608Metric
D2: red MUTED; LED_0603_1608Metric
D3: amber STATE; LED_0603_1608Metric
D4: green ACT; LED_0603_1608Metric
D5: green PWR; LED_0603_1608Metric
H1, H2, H3, H4: M2.5; MountingHole_2.7mm_M2.5
J1, J2: DF40C-100DS-0.4V; Hirose_DF40C-100DS-0.4V_2x50_P0.4mm
J3: HDMI-003; HDMI_A_Plug_Edge_Top
J3B: HDMI-003 (bottom contacts); HDMI_A_Plug_Edge_Bottom
J4, J6: USB4085-GF-A; USB_C_Receptacle_GCT_USB4085
MK1: ICS-43434; InvenSense_ICS-43434-6_3.5x2.65mm
R1, R2: 33; R_0402_1005Metric
R3, R5, R11: 100k; R_0402_1005Metric
R4: 10k; R_0402_1005Metric
R6: 2.2k; R_0402_1005Metric
R7, R13, R14: 1k; R_0402_1005Metric
R8, R9: 56k; R_0402_1005Metric
R12: 330; R_0402_1005Metric
SW1: BOOT; SW_SPST_B3U-1000P
SW2: PCM12SMTR; SW_SPDT_PCM12
U1, U4: USBLC6-2SC6; SOT-23-6
U2, U3: TPS2051CDBV; SOT-23-5
U5, U6: 74LVC1G34; SOT-353_SC-70-5

Connections:
+3V3: C4.1, J1.78 (GPIO_VREF_78), J1.84 (CM5_3.3V_84), J1.86 (CM5_3.3V_86), R7.1, SW2.2 (B), U2.4 (EN)
+5V: C1.1, C2.1, J1.77 (5V_77), J1.79 (5V_79), J1.81 (5V_81), J1.83 (5V_83), J1.85 (5V_85), J1.87 (5V_87), J4.A4 (VBUS), J4.A9 (VBUS), J4.B4 (VBUS), J4.B9 (VBUS), R6.1, U1.5 (VBUS), U2.5 (IN), U3.5 (IN)
+5VP: C3.1, J3B.18 (+5V), U2.1 (OUT)
/BCLK_B: R1.1, U5.4
/CC1: J1.94 (CC1_94), J4.A5 (CC1)
/CC1_H: J6.A5 (CC1), R8.2
/CC2: J1.96 (CC2_96), J4.B5 (CC2)
/CC2_H: J6.B5 (CC2), R9.2
/HDMI_CEC: J2.51 (HDMI0_CEC_151), J3.13 (CEC)
/HDMI_CK_N: J2.90 (HDMI0_CLK_N_190), J3B.12 (CK-)
/HDMI_CK_P: J2.88 (HDMI0_CLK_P_188), J3B.10 (CK+)
/HDMI_D0_N: J2.84 (HDMI0_TX0_N_184), J3.9 (D0-)
/HDMI_D0_P: J2.82 (HDMI0_TX0_P_182), J3.7 (D0+)
/HDMI_D1_N: J2.78 (HDMI0_TX1_N_178), J3B.6 (D1-)
/HDMI_D1_P: J2.76 (HDMI0_TX1_P_176), J3B.4 (D1+)
/HDMI_D2_N: J2.72 (HDMI0_TX2_N_172), J3.3 (D2-)
/HDMI_D2_P: J2.70 (HDMI0_TX2_P_170), J3.1 (D2+)
/HDMI_HPD: J2.53 (HDMI0_HOTPLUG_153), J3.19 (HPD)
/HDMI_SCL: J2.100 (HDMI0_SCL_200), J3.15 (SCL)
/HDMI_SDA: J2.99 (HDMI0_SDA_199), J3B.16 (SDA)
/I2S_BCLK: J1.49 (GPIO18_49), U5.2
/I2S_WS: J1.26 (GPIO19_26), U6.2
/LED_ACT_A: D4.2 (A), R7.2
/LED_LIVE_A: D1.2 (A), R13.2
/LED_MUTED_A: D2.2 (A), R14.2
/LED_PWR_A: D5.2 (A), R6.2
/LED_STATE_A: D3.2 (A), R12.2
/LED_nACT: D4.1 (K), J1.21 (LED_nACT_21)
/MIC_BCLK: MK1.4 (SCK), R1.2
/MIC_LIVE: J1.34 (GPIO5_34), R4.2, R5.1
/MIC_SD0: J1.27 (GPIO20_27), MK1.6 (SD), R3.1
/MIC_WS: MK1.1 (WS), R2.2
/MUTED: R14.1, SW2.3 (C)
/STATE_LED: J1.30 (GPIO6_30), R12.1
/USB_DN: J2.3 (USB_N_103), J4.A7 (D-), J4.B7 (D-), U1.3 (I/O2), U1.4 (I/O2)
/USB_DP: J2.5 (USB_P_105), J4.A6 (D+), J4.B6 (D+), U1.1 (I/O1), U1.6 (I/O1)
/USB_H_DN: J2.36 (USB3-0-DM_136), J6.A7 (D-), J6.B7 (D-), U4.3 (I/O2), U4.4 (I/O2)
/USB_H_DP: J2.34 (USB3-0-DP_134), J6.A6 (D+), J6.B6 (D+), U4.1 (I/O1), U4.6 (I/O1)
/VBUS_HOST: C5.1, J6.A4 (VBUS), J6.A9 (VBUS), J6.B4 (VBUS), J6.B9 (VBUS), R8.1, R9.1, U3.1 (OUT), U4.5 (VBUS)
/WS_B: R2.1, U6.4
/nRPIBOOT: J1.93 (nRPIBOOT_93), SW1.1
GND: C1.2, C2.2, C3.2, C4.2, C5.2, C6.2, C7.2, C8.2, C10.2, D1.1 (K), D2.1 (K), D3.1 (K), D5.1 (K), J1.1 (GND_1), J1.2 (GND_2), J1.7 (GND_7), J1.8 (GND_8), J1.13 (GND_13), J1.14 (GND_14), J1.22 (GND_22), J1.23 (GND_23), J1.32 (GND_32), J1.33 (GND_33), J1.42 (GND_42), J1.43 (GND_43), J1.52 (GND_52), J1.53 (GND_53), J1.59 (GND_59), J1.60 (GND_60), J1.65 (GND_65), J1.66 (GND_66), J1.71 (GND_71), J1.74 (GND_74), J1.98 (GND_98), J2.7 (GND_107), J2.8 (GND_108), J2.13 (GND_113), J2.14 (GND_114), J2.19 (GND_119), J2.20 (GND_120), J2.25 (GND_125), J2.26 (GND_126), J2.31 (GND_131), J2.32 (GND_132), J2.37 (GND_137), J2.38 (GND_138), J2.44 (GND_144), J2.50 (GND_150), J2.55 (GND_155), J2.56 (GND_156), J2.61 (GND_161), J2.62 (GND_162), J2.67 (GND_167), J2.68 (GND_168), J2.73 (GND_173), J2.74 (GND_174), J2.79 (GND_179), J2.80 (GND_180), J2.85 (GND_185), J2.86 (GND_186), J2.91 (GND_191), J2.92 (GND_192), J2.97 (GND_197), J2.98 (GND_198), J3.5 (D1S), J3.11 (CKS), J3.17 (GND), J3.SH, J3B.2 (D2S), J3B.8 (D0S), J3B.SH, J4.A1 (GND), J4.A12 (GND), J4.B1 (GND), J4.B12 (GND), J4.SH (SHIELD), J6.A1 (GND), J6.A12 (GND), J6.B1 (GND), J6.B12 (GND), J6.SH (SHIELD), MK1.2 (LR), MK1.3 (GND), R3.2, R5.2, R11.2, SW1.2, U1.2 (GND), U2.2 (GND), U3.2 (GND), U4.2 (GND), U5.3 (GND), U6.3 (GND)
MIC_VDD: C6.1, C7.1, C8.1, C10.1, MK1.5 (VDD), R4.1, R11.1, R13.1, SW2.1 (A), U3.4 (EN), U5.5 (VCC), U6.5 (VCC)

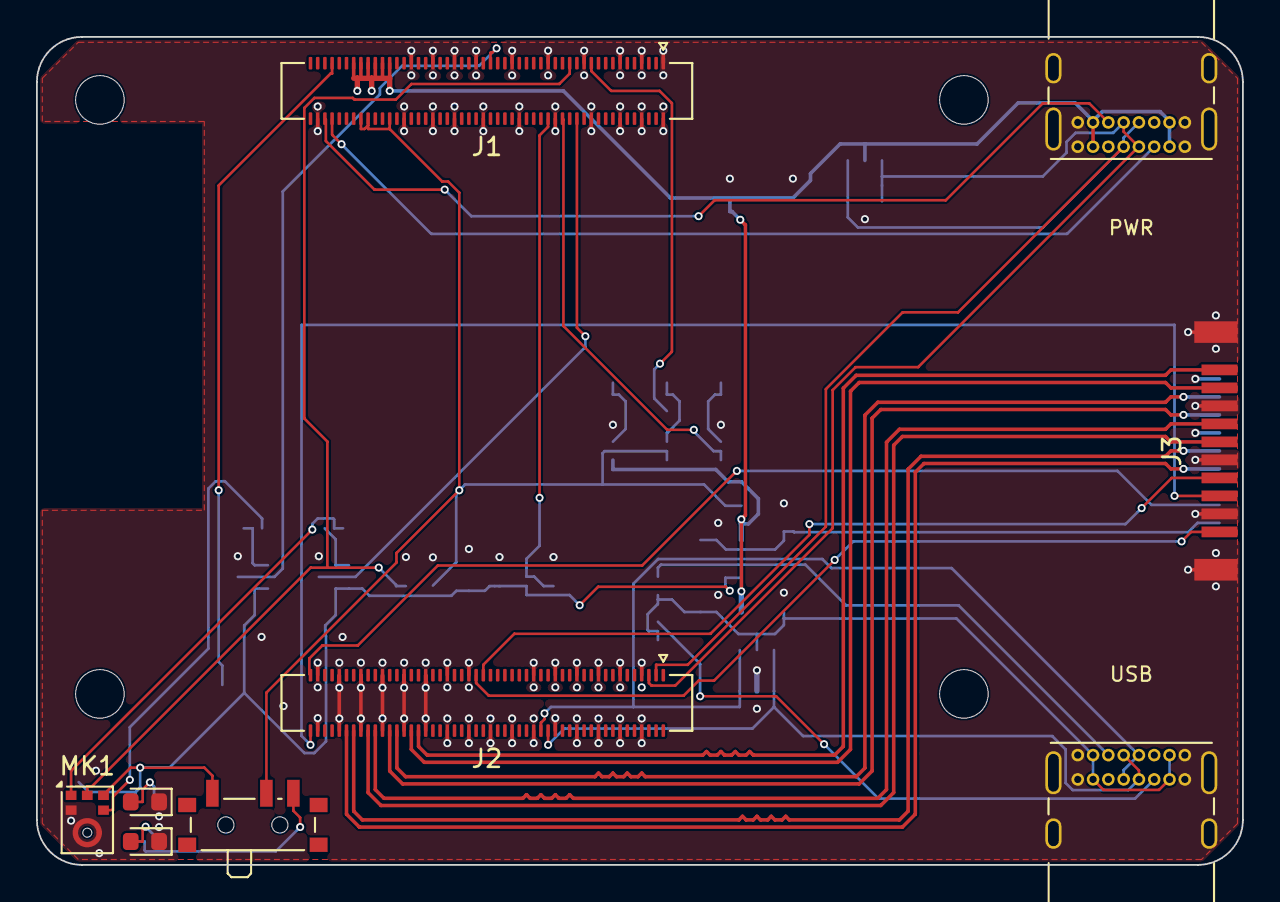
[picture p59: board hardware/v0.4/dongle/agentcast_dongle.kicad_pcb from above]

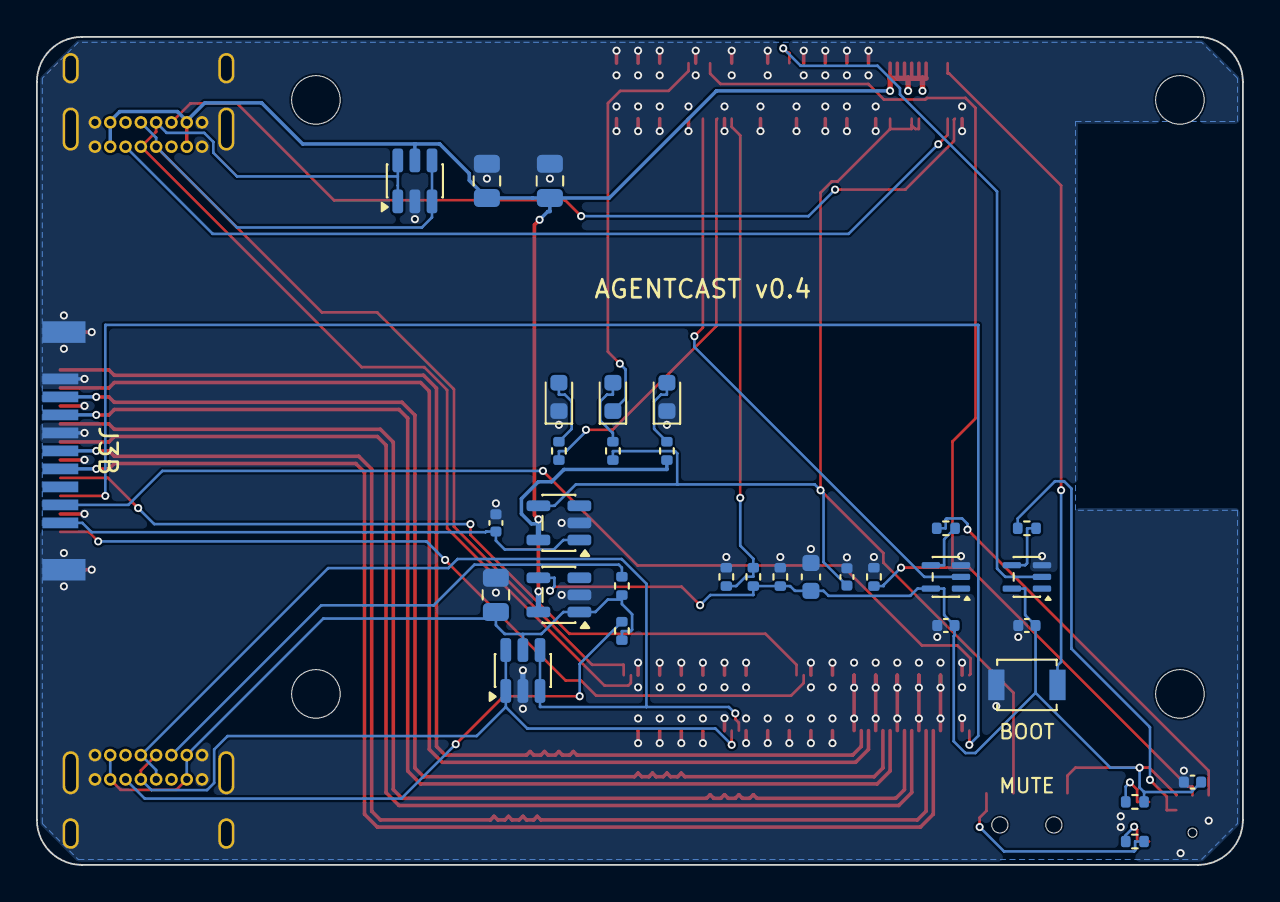
[picture p60: board hardware/v0.4/dongle/agentcast_dongle.kicad_pcb from below]

Board: 4 copper layers, 67.0 x 46.0 mm, 46 parts (33 on the bottom side), 43 nets.
