ThyFriendlyFox/agentcast-prototype/hardware/v0.1/micbar/agentcast_micbar.kicad_pcb

## KiCad design hardware/v0.1/micbar/agentcast_micbar.kicad_pcb (2026-11-05, an earlier design)

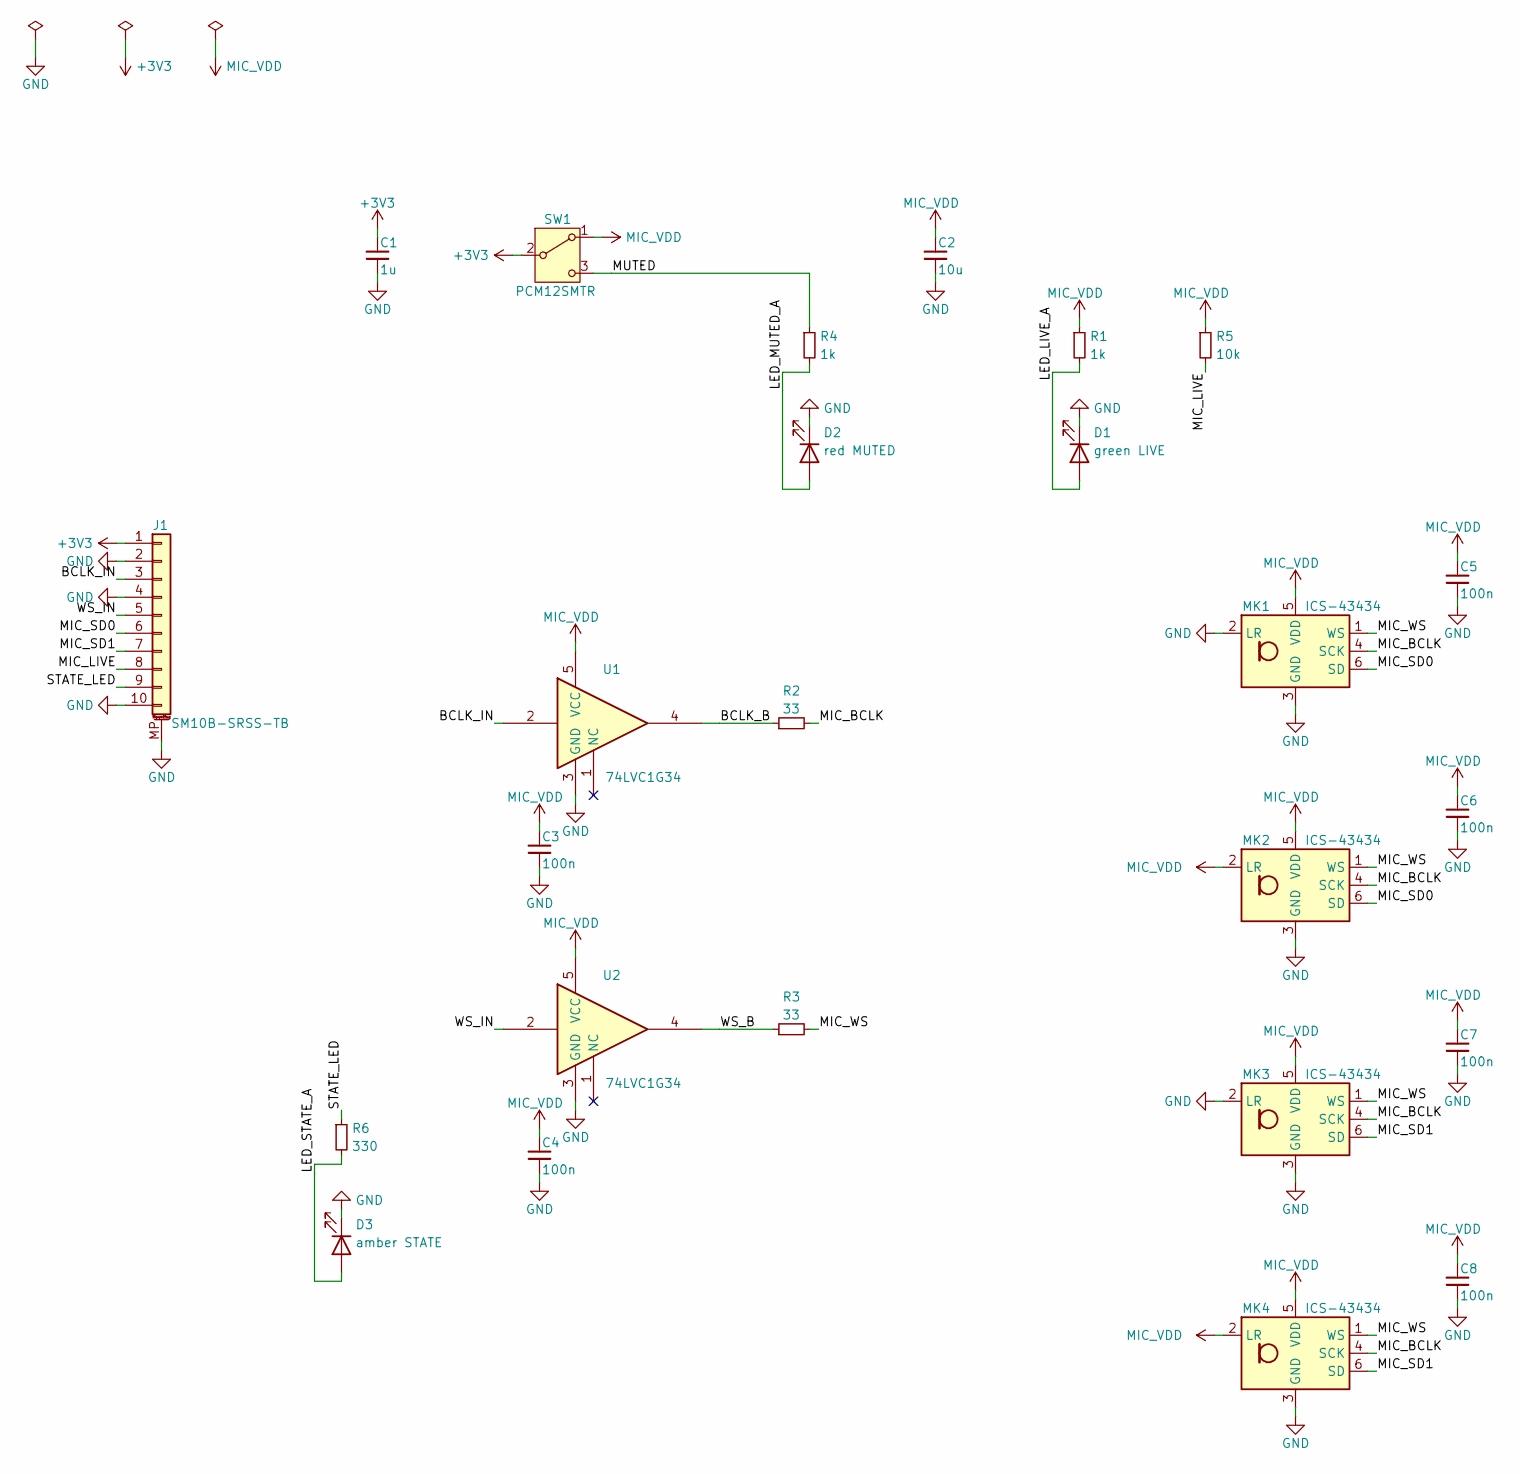
[picture p64: schematic agentcast_micbar.kicad_sch]

Parts:
C1: 1u; C_0402_1005Metric
C2: 10u; C_0603_1608Metric
C3, C4, C5, C6, C7, C8: 100n; C_0402_1005Metric
D1: green LIVE; LED_0603_1608Metric
D2: red MUTED; LED_0603_1608Metric
D3: amber STATE; LED_0603_1608Metric
J1: SM10B-SRSS-TB; JST_SH_SM10B-SRSS-TB_1x10-1MP_P1.00mm_Horizontal
MK1, MK2, MK3, MK4: ICS-43434; InvenSense_ICS-43434-6_3.5x2.65mm
R1, R4: 1k; R_0402_1005Metric
R2, R3: 33; R_0402_1005Metric
R5: 10k; R_0402_1005Metric
R6: 330; R_0402_1005Metric
SW1: PCM12SMTR; SW_SPDT_PCM12
U1, U2: 74LVC1G34; SOT-353_SC-70-5

Connections:
+3V3: C1.1, J1.1, SW1.2 (B)
/BCLK_B: R2.1, U1.4
/BCLK_IN: J1.3, U1.2
/LED_LIVE_A: D1.2 (A), R1.2
/LED_MUTED_A: D2.2 (A), R4.2
/LED_STATE_A: D3.2 (A), R6.2
/MIC_BCLK: MK1.4 (SCK), MK2.4 (SCK), MK3.4 (SCK), MK4.4 (SCK), R2.2
/MIC_LIVE: J1.8, R5.2
/MIC_SD0: J1.6, MK1.6 (SD), MK2.6 (SD)
/MIC_SD1: J1.7, MK3.6 (SD), MK4.6 (SD)
/MIC_WS: MK1.1 (WS), MK2.1 (WS), MK3.1 (WS), MK4.1 (WS), R3.2
/MUTED: R4.1, SW1.3 (C)
/STATE_LED: J1.9, R6.1
/WS_B: R3.1, U2.4
/WS_IN: J1.5, U2.2
GND: C1.2, C2.2, C3.2, C4.2, C5.2, C6.2, C7.2, C8.2, D1.1 (K), D2.1 (K), D3.1 (K), J1.2, J1.4, J1.10, J1.MP (MountPin), MK1.2 (LR), MK1.3 (GND), MK2.3 (GND), MK3.2 (LR), MK3.3 (GND), MK4.3 (GND), U1.3 (GND), U2.3 (GND)
MIC_VDD: C2.1, C3.1, C4.1, C5.1, C6.1, C7.1, C8.1, MK1.5 (VDD), MK2.2 (LR), MK2.5 (VDD), MK3.5 (VDD), MK4.2 (LR), MK4.5 (VDD), R1.1, R5.1, SW1.1 (A), U1.5 (VCC), U2.5 (VCC)

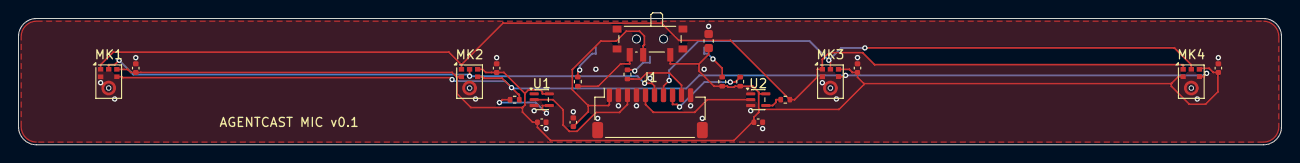
[picture p65: board agentcast_micbar.kicad_pcb from above]

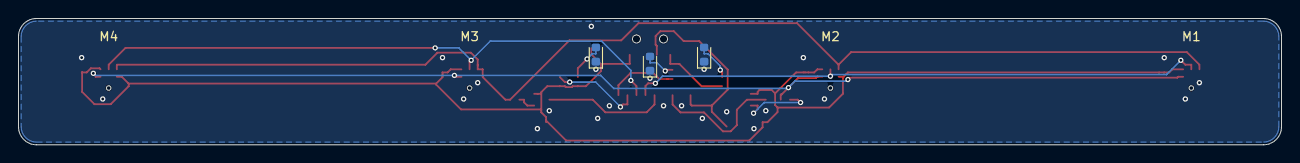
[picture p66: board agentcast_micbar.kicad_pcb from below]

Board: 2 copper layers, 140.0 x 14.0 mm, 25 parts (3 on the bottom side), 17 nets.
