ThyFriendlyFox/agentcast-prototype/(commit log)

2026-11-05 Add hardware v0.1: CM5 HDMI dongle and mic bar
    Two boards made with the Via EE Workcenter from docs/office-agent-dongle.md.
    Main board: Raspberry Pi CM5 carrier, HDMI-A out with 4 hand-routed
    100 ohm pairs (0.000 mm in-pair skew), USB-C power and rpiboot, mic bar
    socket. Mic bar: 4 ICS-43434 on one I2S clock, 2 data lanes, hardware
    mute that cuts the mic supply and drives the LIVE LED.
    Also installs the agent kit, a Makefile (make verify) and CLAUDE.md.
    Evidence: make verify GREEN. main: ERC 0/0, DRC 0 errors 0 unconnected,
    SIM skip (no deck), EXPORT 24 Gerbers. micbar: ERC 0/0, DRC 0 errors,
    SIM 1 deck pass, EXPORT 22 Gerbers.
    Claud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
    [agentcast_main.kicad_pcb, agentcast_main.kicad_sch, agentcast_micbar.kicad_pcb, agentcast_micbar.kicad_sch]
2026-11-05 Add hardware v0.2: one-board dongle with on-board mic
    v0.2 folds v0.1's main board and mic bar into one 57 x 50.4 mm board
    (v0.1: 66 x 52.2 mm plus a 140 x 14 mm bar). Speakers are told apart by
    voice, so the 4-mic array is gone: one ICS-43434 on the board and a
    USB-C host port (J6) for an external USB mic. The mute switch cuts the
    mic, its clock buffers and J6's power switch. HDMI +5V now runs through
    a TPS2051C instead of a diode. Small parts moved to the bottom face.
    dongle/fab/ holds Gerbers, drill, BOM, schematic PDF and pick-and-place
    from `make fab`. v0.1 is archived; only its README banner changed.
    Evidence: make verify GREEN. ERC 0/0, DRC 0 errors 0 unconnected 0
    parity, SIM 1 dec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
    [agentcast_dongle-B_Courtyard.gbr, agentcast_dongle-B_Cu.gbl, agentcast_dongle-B_Fab.gbr, agentcast_dongle-B_Mask.gbs, agentcast_dongle-B_Paste.gbp, agentcast_dongle-B_Silkscreen.gbo, agentcast_dongle-Edge_Cuts.gm1, agentcast_dongle-F_Courtyard.gbr]
2026-11-05 Add hardware v0.3: the dongle as a 67 x 46 mm stick
    v0.3 turns v0.2's 57 x 50.4 mm board into a stick: HDMI-A out of the
    end, USB-C power and the USB-C external-mic port out of the two long
    sides beside it, the mic and mute switch in a strip below the module.
    The width floor is the CM5 (40 mm).
    The USB-C ports were black boxes in v0.2's renders (no KiCad 3D body for
    the HRO part); v0.3 uses the GCT USB4085, which has one. `render
    --strict` passes: every part has a body. `make assembly` renders the
    board with Raspberry Pi's CM5 model on it (fetched, not committed).
    CM5 sockets and holes checked against Raspberry Pi's CM5 3D model
    (RP-007222-DD-2): connectors at (25.0, 3.0) and (25.0, 37.0)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
    [agentcast_dongle-B_Courtyard.gbr, agentcast_dongle-B_Cu.gbl, agentcast_dongle-B_Fab.gbr, agentcast_dongle-B_Mask.gbs, agentcast_dongle-B_Paste.gbp, agentcast_dongle-B_Silkscreen.gbo, agentcast_dongle-Edge_Cuts.gm1, agentcast_dongle-F_Courtyard.gbr]
2026-11-05 Add hardware v0.4: male HDMI plug on the stick's end
    A TV dongle plugs straight into the TV, so v0.4 replaces v0.3's HDMI
    receptacle with a male HDMI Type-A plug clamped on the board's near
    edge: odd contacts on the top face (J3), even on the bottom (J3B, not in
    the BOM). KiCad has no such footprint; gen_library.py draws it from the
    HDMI Type-A contact layout (19 contacts, 1.0 mm pitch per row, rows
    0.5 mm apart). Pad size, clamp tabs, which face has the odd row and the
    board thickness are named constants awaiting the XUNPU HDMI-003 drawing.
    D2 and D0 end on the top contacts; D1 and CK drop through a via pair
    2.0 mm from the edge to the bottom contacts.
    Evidence: make verify GREEN. ERC 0/0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
    [agentcast_dongle-B_Courtyard.gbr, agentcast_dongle-B_Cu.gbl, agentcast_dongle-B_Fab.gbr, agentcast_dongle-B_Mask.gbs, agentcast_dongle-B_Paste.gbp, agentcast_dongle-B_Silkscreen.gbo, agentcast_dongle-Edge_Cuts.gm1, agentcast_dongle-F_Courtyard.gbr]
2026-11-07 v0.5 work in progress: 72 mm stick, hole-clearance-safe GND vias, P4 SIM deck
    Not routed yet; make verify is not GREEN, so this commit is not pushed.
    Claude-Session: https://claude.ai/code/session_01UhK1vFqJLMoMY7ePA3f1zm
    [agentcast_dongle.kicad_pcb, agentcast_dongle.kicad_sch]
2026-11-07 v0.5: 0.15 mm copper clearance so routed vias keep the hole clearance; ground vias further out
    Not routed yet; make verify is not GREEN, so not pushed.
    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
    [design.py]
2026-11-07 v0.5: hand-routed DSI (three lanes under the P4, CK crossing D1 on In2.Cu, LT8912B data-lane polarity swap)
    Not routed yet; not pushed (make verify not GREEN).
    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
    [design.py]
2026-11-07 v0.5: fan out the P4 and LT8912B pins to vias before routing
    Not pushed (make verify not GREEN).
    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
2026-11-07 v0.5: 6 layers (In1/In4 GND, In2/In3 routing), pairs resized for the 0.1 mm prepreg
    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
2026-11-07 v0.5: fanout keeps escape lanes, QFN grounds tie into the exposed pad, Y2 off the LT8912B
    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
2026-11-07 v0.5: route with lane-keeping fanout (28 unconnected, DRC not GREEN)
    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
    [agentcast_dongle.kicad_pcb, agentcast_dongle.kicad_sch]
2026-11-07 v0.5: board 30 mm wide (2 mm each long side), layout frame shifted, edge parts on the new edges
    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
2026-11-07 v0.5: 30 mm wide, 8 layers (JLC081611-2116)
    Six layers left 26-28 connections open around the P4 even at 30 mm.
    Eight layers give four inner routing layers; pair widths stay
    (about 104 ohm TMDS, 102 ohm DSI on 0.109 mm 2116 prepreg).
    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
2026-11-07 v0.5: fanout splays each pad run into one row of vias, path search for the rest
    At 0.35 mm pitch no track can pass between two 0.4 mm vias, so staggered
    rows box pads in. Each run of neighbouring pads now runs out at pad pitch
    and bends 45 degrees into vias 0.6 mm apart; a Dijkstra path search on a
    0.025 mm grid takes the pads the fan cannot reach. U1: 48 vias (was 40).
    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
2026-11-07 v0.5: finish.py, a rip-up and reroute finisher for what FreeRouting leaves open
    Routes each open net on a 0.025 mm grid over the six routing layers,
    crossing other nets' routed copper at a growing price and rerouting what
    it crosses; GND pads cut off from the pour take a via to the planes.
    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
2026-11-07 v0.5: 80 mm long; the mic circuit moves to the P4's left, bulk caps step out
    Eight layers at 72 mm still left 23 connections open around the P4. The
    board grows 8 mm (the human's offer): the P4, LT8912B and plug move 8 mm
    toward the plug end, the mic, its LDO and buffers leave the P4's bottom
    row for the new gap at its left by the I2S pins, and the P4's bulk caps
    step 1 mm out so its right-side pads keep room for vias. U1 fanout: 52.
    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
2026-11-07 v0.5: route the hard connections first (finish.py --pre, prerouted.json)
    finish.py --pre routes the connections FreeRouting left open on the
    unrouted board, taking neighbours' fanout stubs where a pad is boxed in,
    and writes prerouted.json; design.py adds it as fixed copper before the
    router runs.
    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
    [design.py, finish.py]
2026-11-07 v0.5: flash left of the DSI lanes; D0 runs on so U3 pin 26 gets its via
    The flash moves 2 mm left so all its pins sit on the P4's side of the DSI
    lanes. The TMDS D0 pair jogs 0.6 mm later, which opens a via spot for the
    LT8912B's +1V8 pin 26 (boxed in between D1 and D0 until now); the fanout
    search now also tries straight out. TMDS skew stays 0.
    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
2026-11-07 v0.5: spread the P4's movable GPIOs onto every other free pin
    The C6's UART and BOOT move to GPIO10/12/14 (left, toward the C6); MIC_LIVE,
    STATE_LED and DDC to GPIO27/29/31/32 (right). The top row's run of
    neighbouring signal pins (GPIO39-45) had no room for vias. U1 fanout: 55
    of 62. prerouted.json starts over for the new pins.
    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
2026-11-07 v0.5: prerouted.json for the spread pin plan (8 nets, none left open)
    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
2026-11-08 v0.5: flash turned to the P4's pin order; preroute closes all 15 hard nets
    U4 turns 270 degrees so both its pin rows run in the order of the P4's
    flash pins: HOLD, CK and D no longer cross. The finisher's grid slack goes
    to 0.03 mm (a 5 um clearance miss).
    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
    [design.py, finish.py]
2026-11-08 v0.5: inward vias for pins boxed in outside; a lane check that only guards open lanes
    Between the P4's pad ring and its exposed pad are 0.85 mm a via fits in;
    pins boxed in outside take a via there, and the bottom-face caps under
    the ring step aside from them (flash 31-33, 51, 72). The fanout's lane
    check refused every via once any waiting pad had lost its lane; it now
    guards only the lanes still open. U1 fanout: 59 of 62, U3: 19 of 20.
    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
2026-11-08 v0.5: C10 and C16 step aside; finisher joins cut-off pour islands
    C10 slides clear of pin 33's inward via; C16 leaves the crowded bottom
    row for the P4's bottom right corner. U1 fanout: 60 of 62. finish.py
    finds GND pour islands cut off from the planes (fills joined where a via
    lands) and gives each a via, through a careful crossing if it must; round
    pads count as round when it joins pieces.
    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
2026-11-08 v0.5: flash bus drawn by hand (route_flash); C5 off the flash corner
    The P4's pins 30-33 run to the flash's near row on F.Cu, each in its own
    lane, the leftmost highest, so none cross; pins 27-29 take their vias
    above the lanes, and U4 sits 1.3 mm lower to make room. Pin 30 needs no
    fanout via of its own (single pins can now be skipped by reference).
    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
    [design.py]
2026-11-08 v0.5: U3 pin 58 (I2S_DOUT) picks its via first; the fan keeps vias already placed
    FAN_FIRST lets a pin its neighbours always box in take the spot straight
    out before they fan. The fan pass overwrote the result of every pin in a
    run, losing a via already placed (and leaving its copper); it now skips
    them.
    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
    [design.py]
2026-11-08 v0.5: R1 (DSI_REXT) under U1 between its EP vias
    Under the flash lanes its GND pad had no room for a via and the pour
    around it was cut off.
    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
2026-11-08 v0.5: routed board, DRC 0 errors, 0 unconnected
    FreeRouting, then finish.py --careful (20 tries, two levels): I2S_WS,
    MIC_1V8, CC2_H and a GND pour island joined.
    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
    [agentcast_dongle.kicad_pcb, agentcast_dongle.kicad_sch]
2026-11-08 v0.5: docs for the GREEN 80 x 30 mm board; make design runs the finisher
    README: size, layout and routing (fanout, inward vias, hand-drawn flash
    bus, finish.py), the two workcenter gaps worked around, pictures. STATUS,
    CHANGELOG, DEVLOG, top README follow.
    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
2026-11-08 gitignore KiCad lock files
    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
2026-11-08 v0.5: pictures, fab files, a 3D body for the C6 module
    workcenter render --strict wanted a body for U2: KiCad's ESP32-C6-MINI-1
    model is not installed in the workcenter, so models/ has a box the size
    of its fab outline. docs/ holds the renders, fab/ the EXPORT gate's
    Gerbers, drill, BOM and schematic plus a pick-and-place file (make fab).
    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
    [agentcast_dongle-B_Courtyard.gbr, agentcast_dongle-B_Cu.gbl, agentcast_dongle-B_Fab.gbr, agentcast_dongle-B_Mask.gbs, agentcast_dongle-B_Paste.gbp, agentcast_dongle-B_Silkscreen.gbo, agentcast_dongle-Edge_Cuts.gm1, agentcast_dongle-F_Courtyard.gbr]
